SkillSurf/frac-n-pll-vco-mixdes_2026/HFSS Inductor Files/Workflow Development/Inductor_Workflow.drawio (3).png

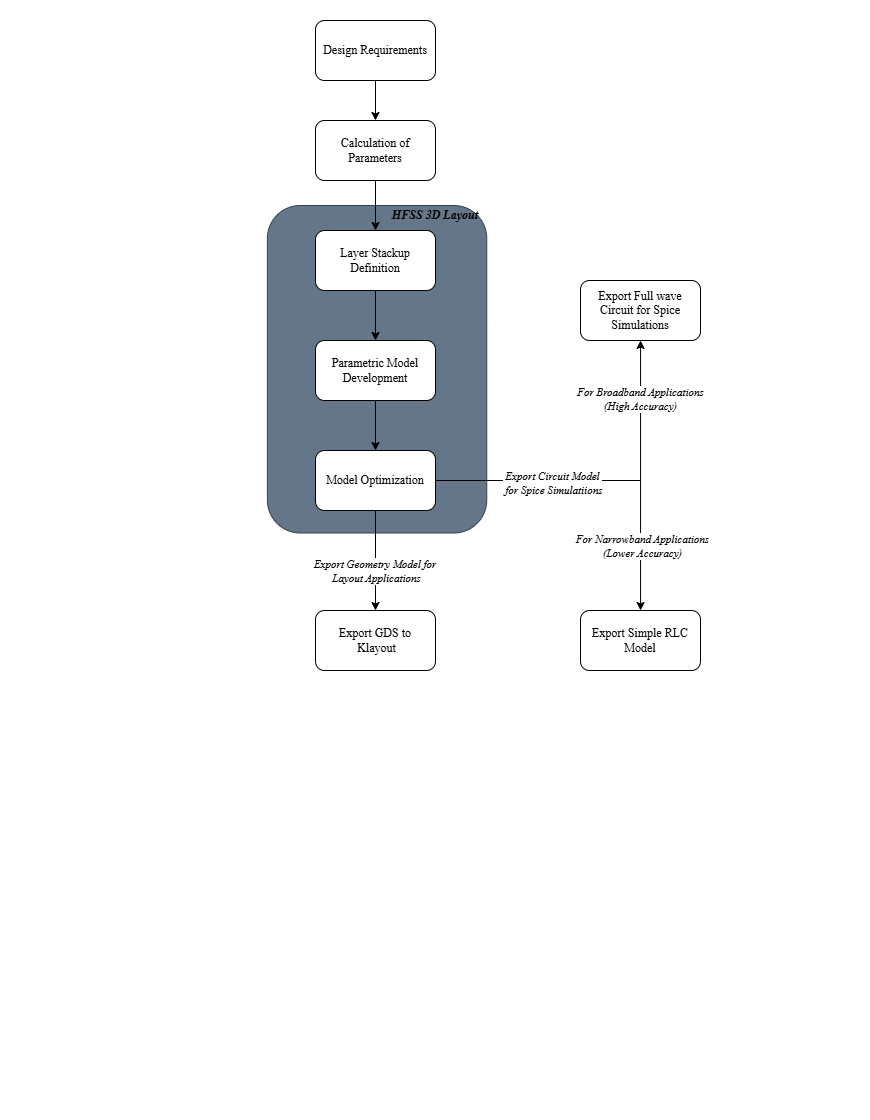
HFSS Inductor Files/Workflow Development/Inductor_Workflow.drawio (3).png
