SkillSurf/frac-n-pll-vco-mixdes_2026/layout/images/PFD.png

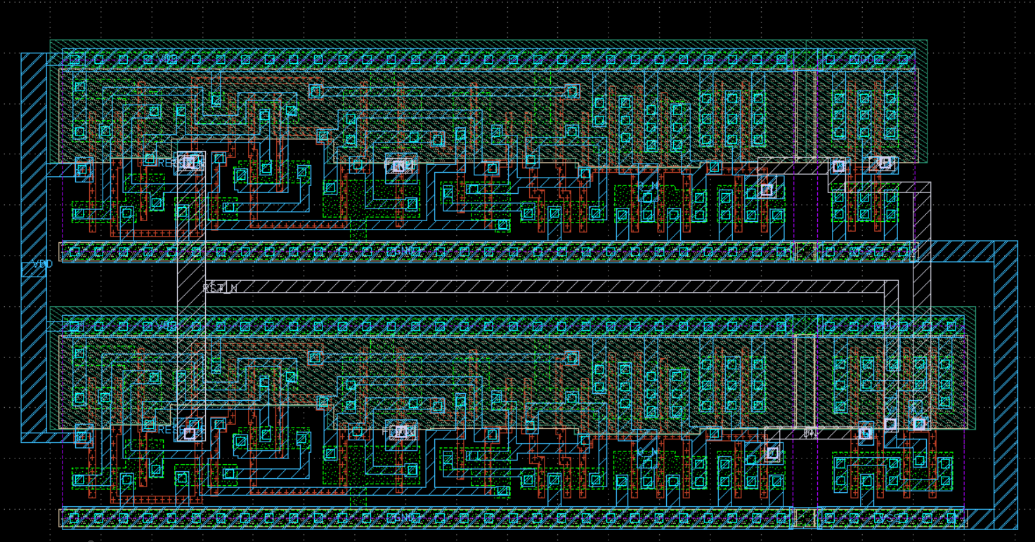
layout/images/PFD.png
