SkillSurf/frac-n-pll-vco-mixdes_2026/pex/images/PFD_CP_pex.png

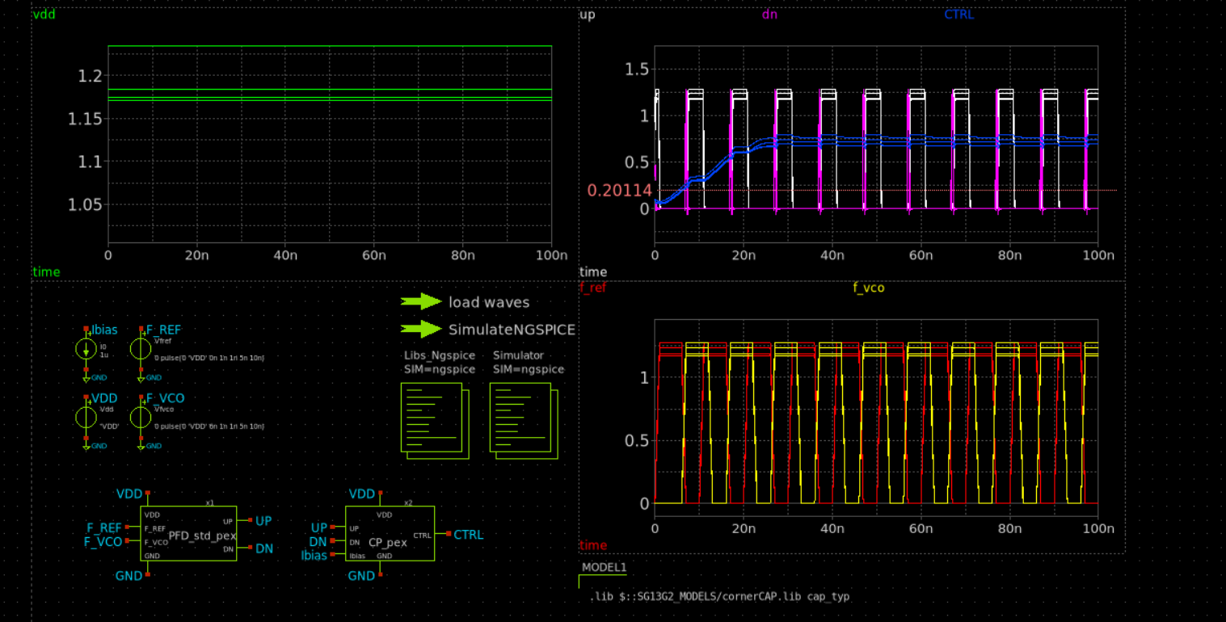
pex/images/PFD_CP_pex.png
