SkillSurf/frac-n-pll-vco-mixdes_2026/schematic/blocks/freq_divider/techmap-stats.png

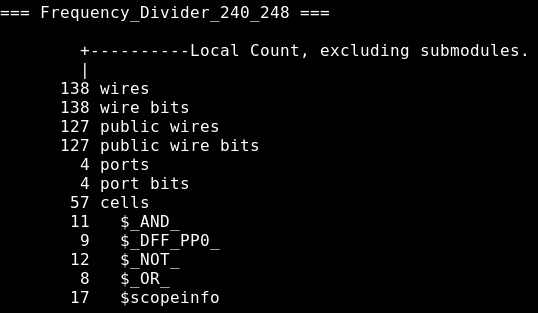
schematic/blocks/freq_divider/techmap-stats.png
