SkillSurf/frac-n-pll-vco-mixdes_2026/schematic/blocks/lc-vco/images/VCO_swing_0.6.png

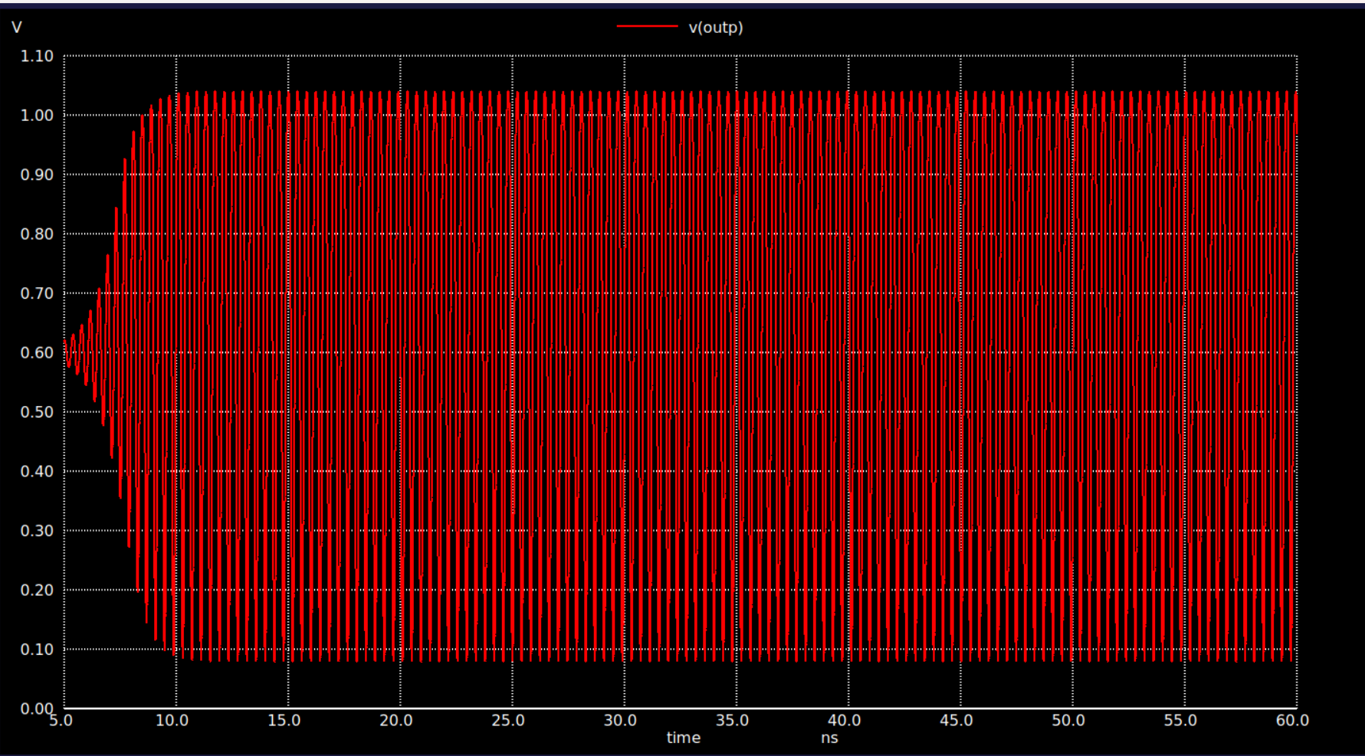
schematic/blocks/lc-vco/images/VCO_swing_0.6.png
