SkillSurf/frac-n-pll-vco-mixdes_2026/schematic/blocks/lc-vco/images/VCO_sym.png

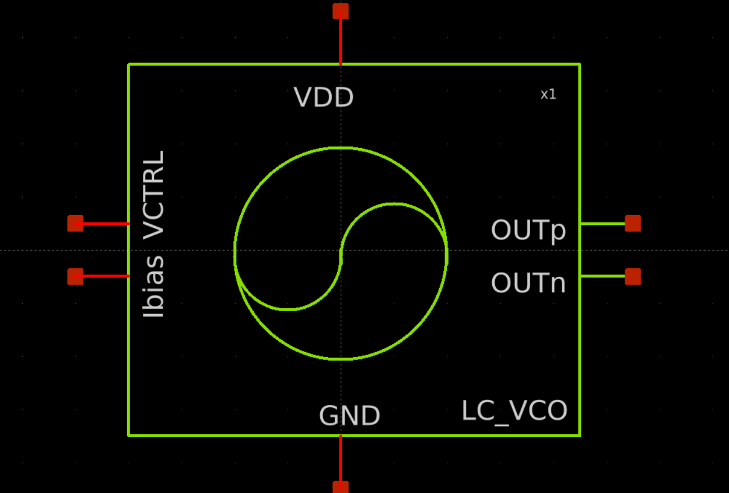
schematic/blocks/lc-vco/images/VCO_sym.png
