SkillSurf/frac-n-pll-vco-mixdes_2026/schematic/blocks/lc-vco/images/VCO_tb.png

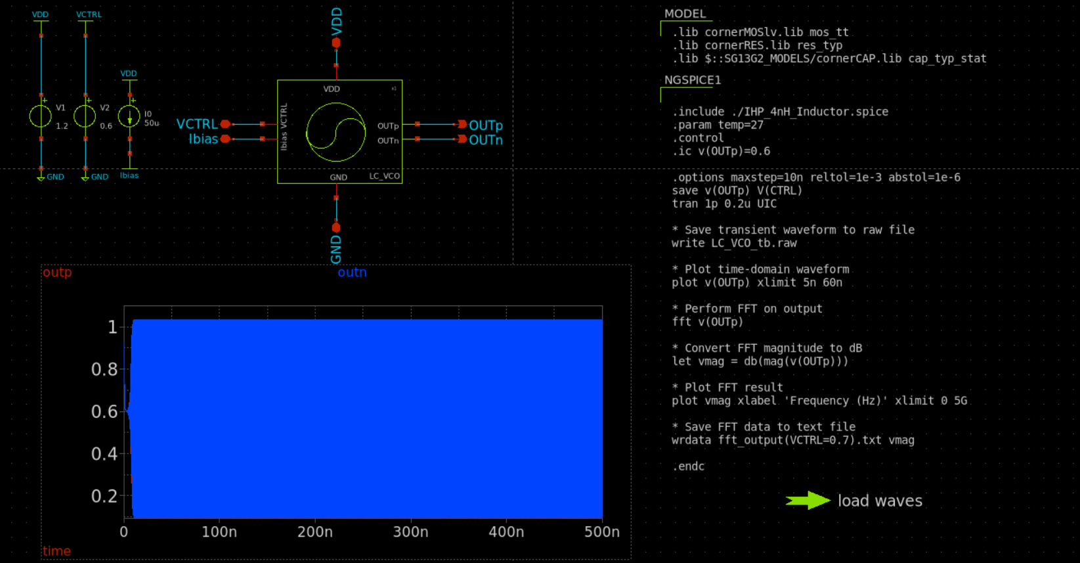
schematic/blocks/lc-vco/images/VCO_tb.png
