SkillSurf/frac-n-pll-vco-mixdes_2026/schematic/blocks/lc-vco/images/VCO_Vcon_vs_Frequency.png

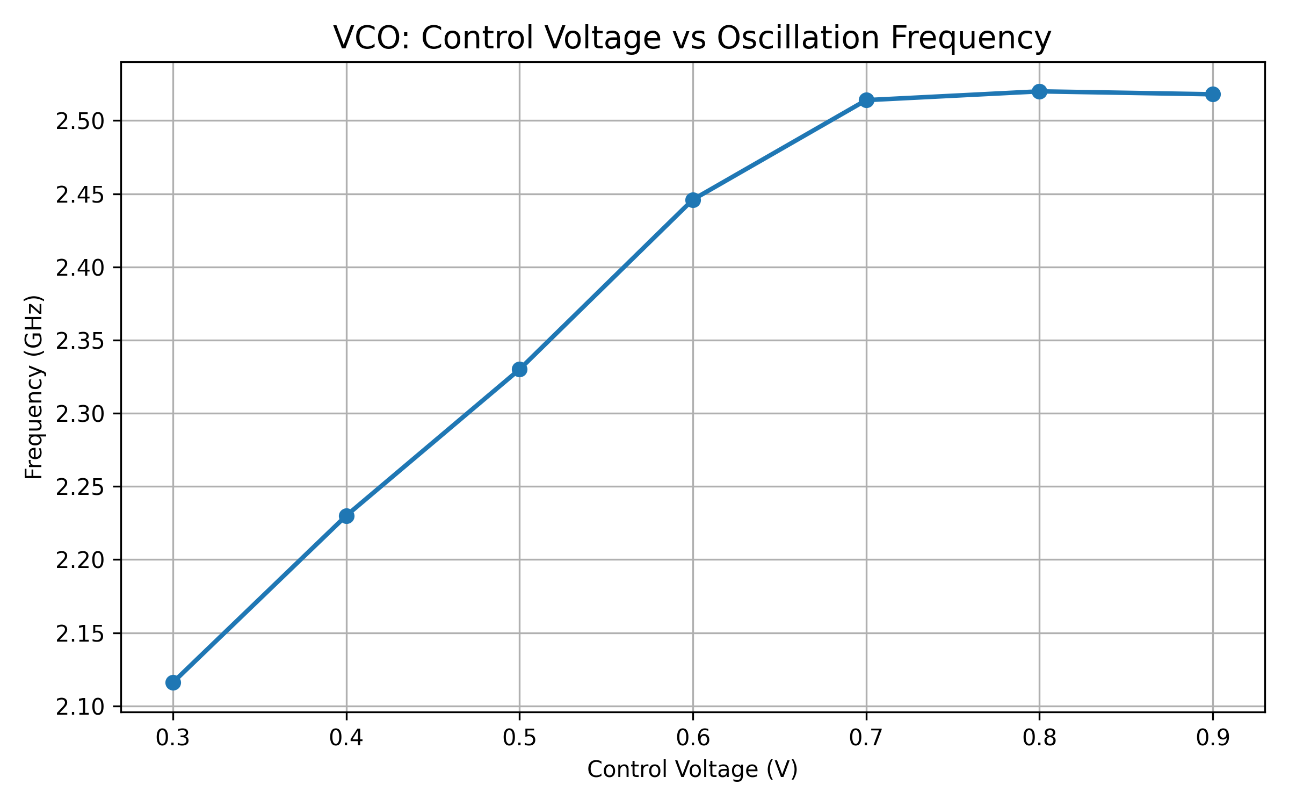
schematic/blocks/lc-vco/images/VCO_Vcon_vs_Frequency.png
