SkillSurf/frac-n-pll-vco-mixdes_2026/schematic/blocks/lc-vco/inductor/images/Inductor_symbol.png

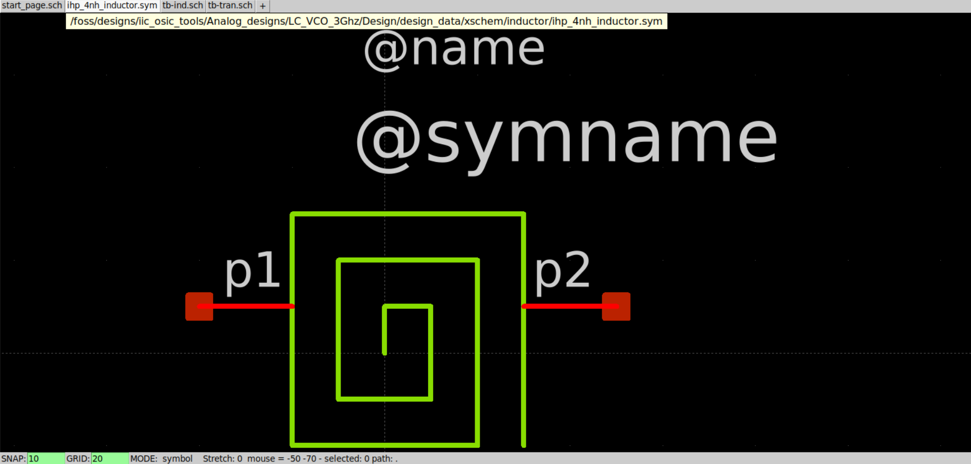
schematic/blocks/lc-vco/inductor/images/Inductor_symbol.png
