SkillSurf/frac-n-pll-vco-mixdes_2026/schematic/blocks/lc-vco/inductor/images/plot_tb_trans.png

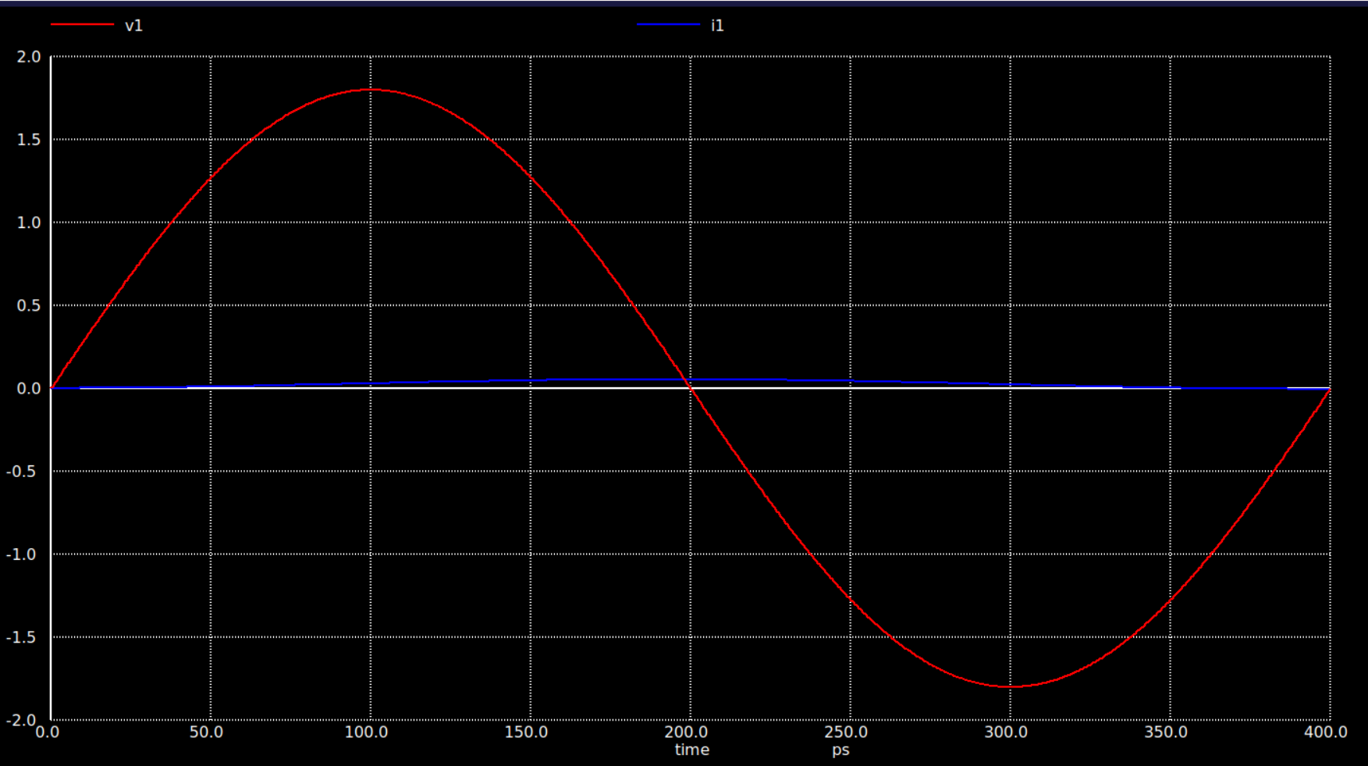
schematic/blocks/lc-vco/inductor/images/plot_tb_trans.png
