SkillSurf/frac-n-pll-vco-mixdes_2026/schematic/blocks/lc-vco/simulations/plot/Phase_Noise_2p45GHz.png

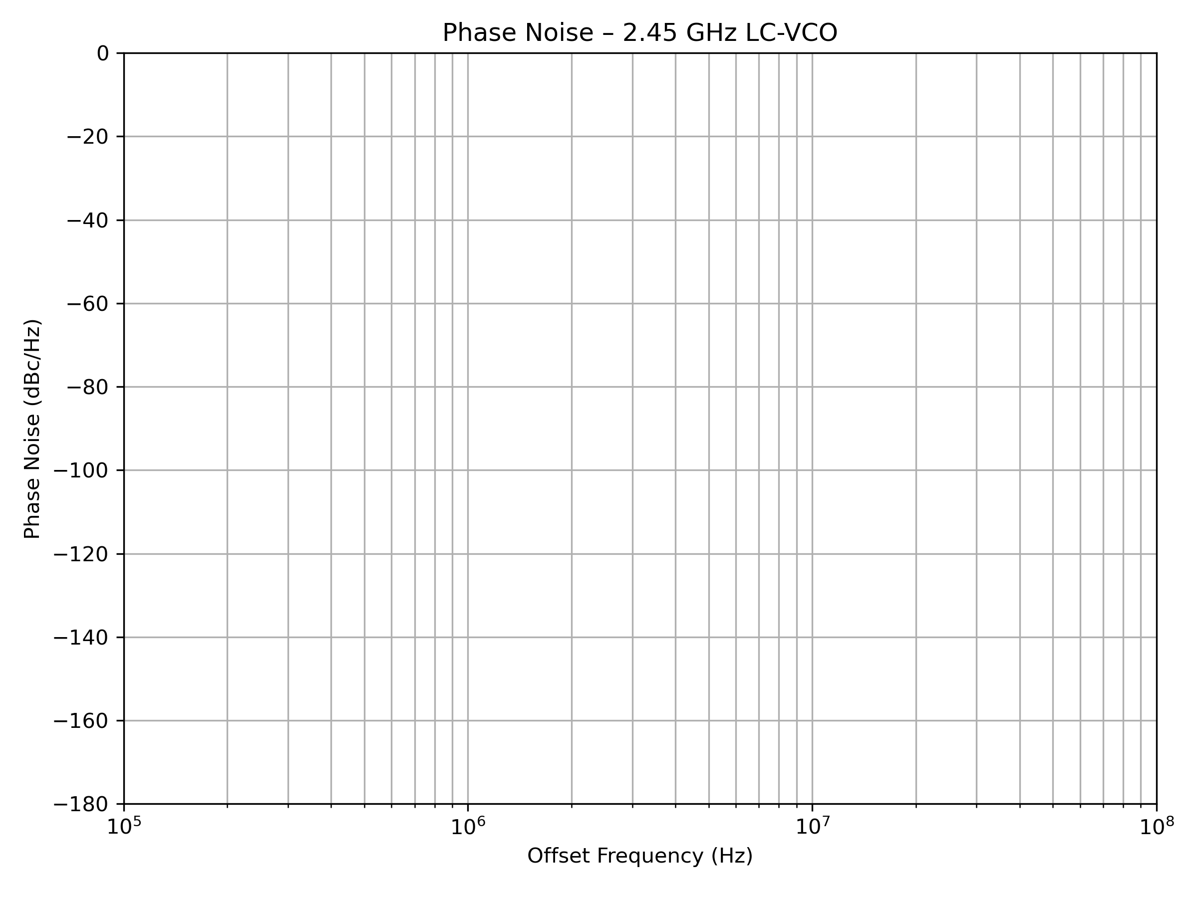
schematic/blocks/lc-vco/simulations/plot/Phase_Noise_2p45GHz.png
