SkillSurf/frac-n-pll-vco-mixdes_2026/schematic/blocks/top-pll/images/Pll_tb.png

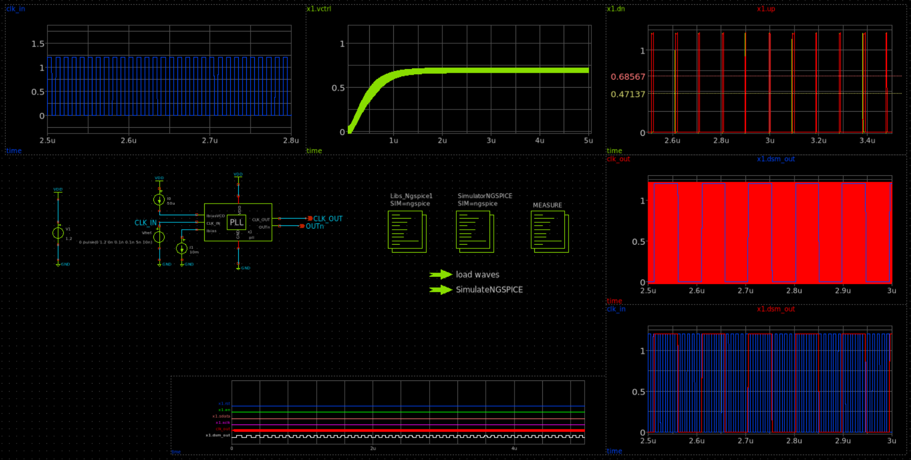
schematic/blocks/top-pll/images/Pll_tb.png
