SkillSurf/frac-n-pll-vco-mixdes_2026/schematic/blocks/top-pll/plots/phase_noise.png

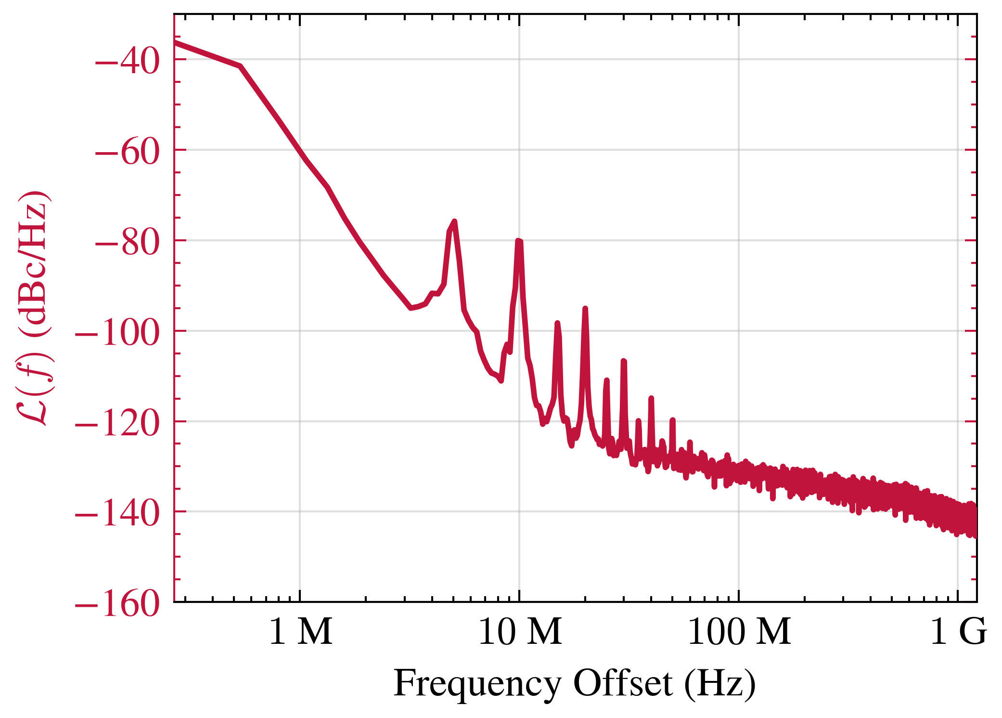
schematic/blocks/top-pll/plots/phase_noise.png
