SkillSurf/frac-n-pll-vco-mixdes_2026/schematic/images/PFD.png

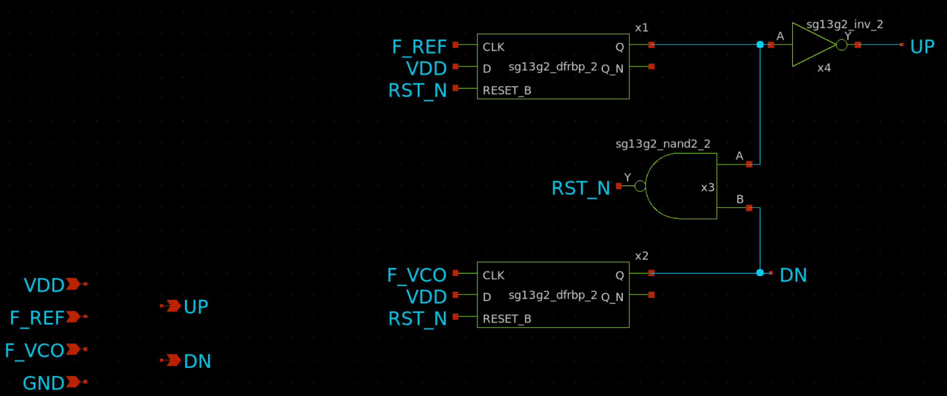
schematic/images/PFD.png
