SkillSurf/frac-n-pll-vco-mixdes_2026/HFSS Inductor Files/Results/Final_Inductor/All_params_5_increased.csv

F [GHz] | Qdiff [] | Ldiff []
0
0.05 | 0.910361637169144 | 4.29419219708574
0.1 | 1.76039034699172 | 4.25789537944545
0.15 | 2.54506056684483 | 4.23875671993914
0.2 | 3.25487046245863 | 4.21809282917082
0.25 | 3.89719435265132 | 4.19805023388162
0.3 | 4.48102549748517 | 4.17944842649672
0.35 | 5.01460024907749 | 4.16243543072328
0.4 | 5.50533651928868 | 4.14693331860913
0.45 | 5.95999063664323 | 4.13282926772102
0.5 | 6.3846467579813 | 4.12003157787052
0.55 | 6.78463216509041 | 4.10847437201323
0.6 | 7.1644562598025 | 4.09810870606439
0.65 | 7.5278060824558 | 4.08889338997171
0.7 | 7.87759221703071 | 4.08078884124879
0.75 | 8.2160265388206 | 4.07375391155874
0.8 | 8.54471414900162 | 4.06774480066577
0.85 | 8.86474696003942 | 4.0627151967697
0.9 | 9.17679157075253 | 4.05861701666249
0.95 | 9.48116795135646 | 4.05540134983289
1 | 9.77791794306177 | 4.05301938340479
1.05 | 10.0690299022583 | 4.05119957784507
1.1 | 10.3542766584777 | 4.05009197370117
1.15 | 10.6337782409399 | 4.04965374898799
1.2 | 10.9076153185074 | 4.04984639711033
1.25 | 11.1758411040774 | 4.0506355244101
1.3 | 11.4384896625119 | 4.05199056652454
1.35 | 11.6955816876259 | 4.0538844688765
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
