SkillSurf/frac-n-pll-vco-mixdes_2026/HFSS Inductor Files/Results/Final_Inductor/Final_inductor.csv

F [GHz] | Qdiff [] | Ldiff []
0
0.05 | 0.862573039718039 | 4.10525818600669
0.1 | 1.67220735884419 | 4.07071218966913
0.15 | 2.42566952697537 | 4.05225157533128
0.2 | 3.11565455376951 | 4.03279449870715
0.25 | 3.74878208598265 | 4.01425768118646
0.3 | 4.33260738004381 | 3.99729994173391
0.35 | 4.87380078047865 | 3.98198138041417
0.4 | 5.37823164227914 | 3.96817067582261
0.45 | 5.85120981924595 | 3.95571534778021
0.5 | 6.29754746685794 | 3.94449109536643
0.55 | 6.72151697179213 | 3.9344052907229
0.6 | 7.12679826210816 | 3.9253881169922
0.65 | 7.51645709816149 | 3.91738327051713
0.7 | 7.89296009178875 | 3.91034131281371
0.75 | 8.25821743618163 | 3.90421572484065
0.8 | 8.61364159552477 | 3.89896094132877
0.85 | 8.96021229511368 | 3.89453163008362
0.9 | 9.29854132849784 | 3.89088266431288
0.95 | 9.62893346703466 | 3.88796942512268
1 | 9.95144173518222 | 3.88574821650602
1.05 | 10.2696115156658 | 3.88389998702406
1.1 | 10.581702154924 | 3.88266829767457
1.15 | 10.8877865917051 | 3.88201003346301
1.2 | 11.1879153720431 | 3.88188712694364
1.25 | 11.4821246913236 | 3.88226610160251
1.3 | 11.7704416163814 | 3.8831175986448
1.35 | 12.0528873993499 | 3.88441591788408
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
