SkillSurf/frac-n-pll-vco-mixdes_2026/HFSS Inductor Files/Results/Final_Inductor/inductor_comparison_plot.png

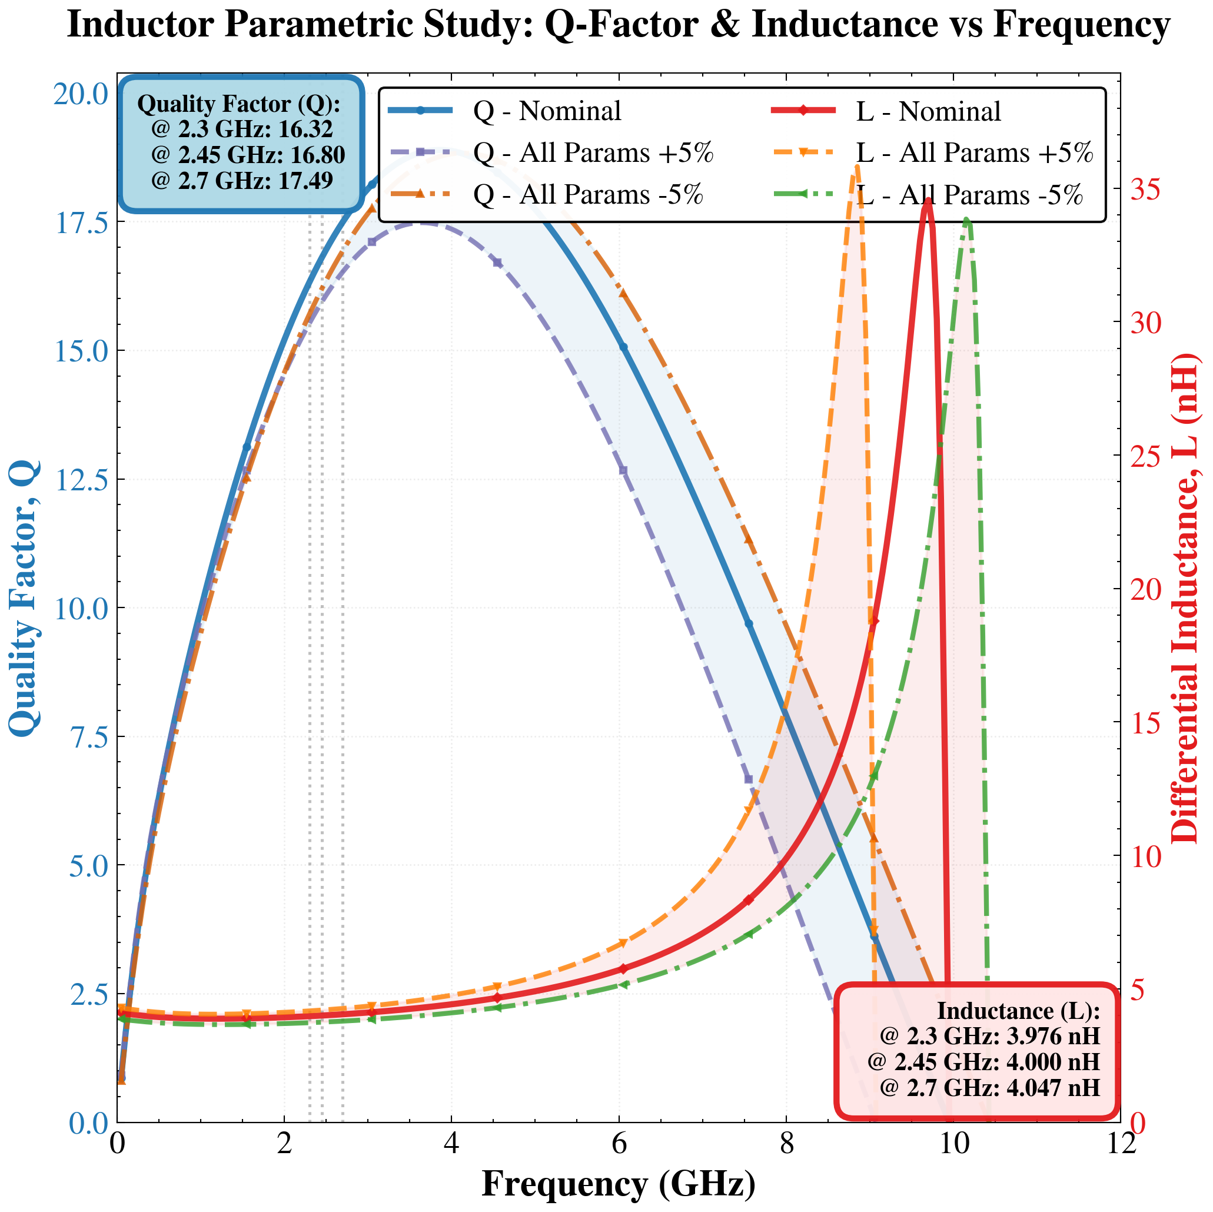
HFSS Inductor Files/Results/Final_Inductor/inductor_comparison_plot.png
