SkillSurf/frac-n-pll-vco-mixdes_2026/HFSS Inductor Files/Results/Results for the 2port inductor/radius_plots/dual_axis_L_Q_vs_frequency.png

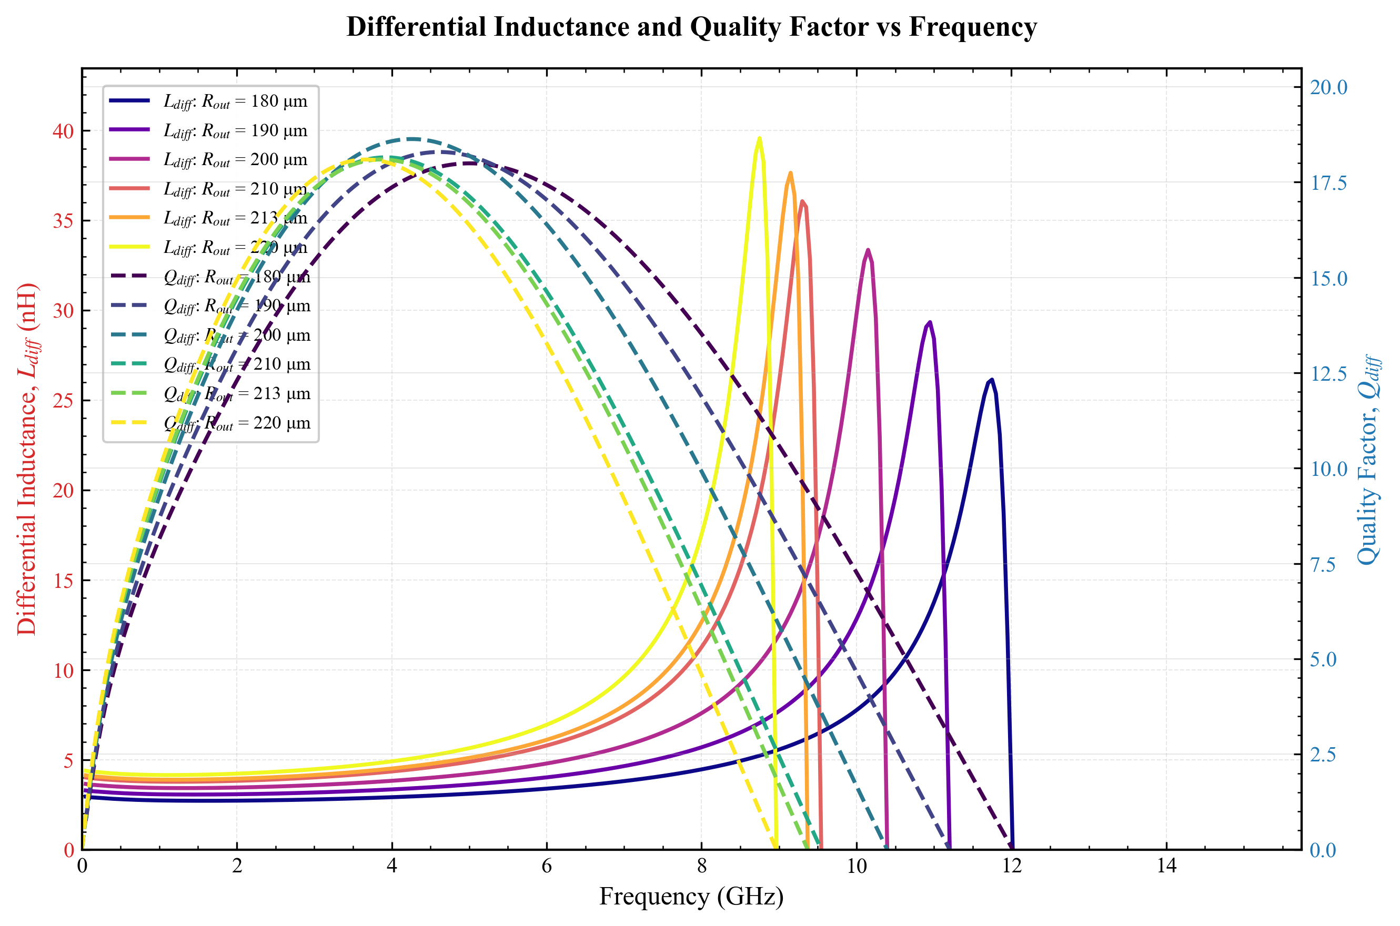
HFSS Inductor Files/Results/Results for the 2port inductor/radius_plots/dual_axis_L_Q_vs_frequency.png
