SkillSurf/frac-n-pll-vco-mixdes_2026/HFSS Inductor Files/Results/Results for the 2port inductor/radius_plots/L_vs_frequency.png

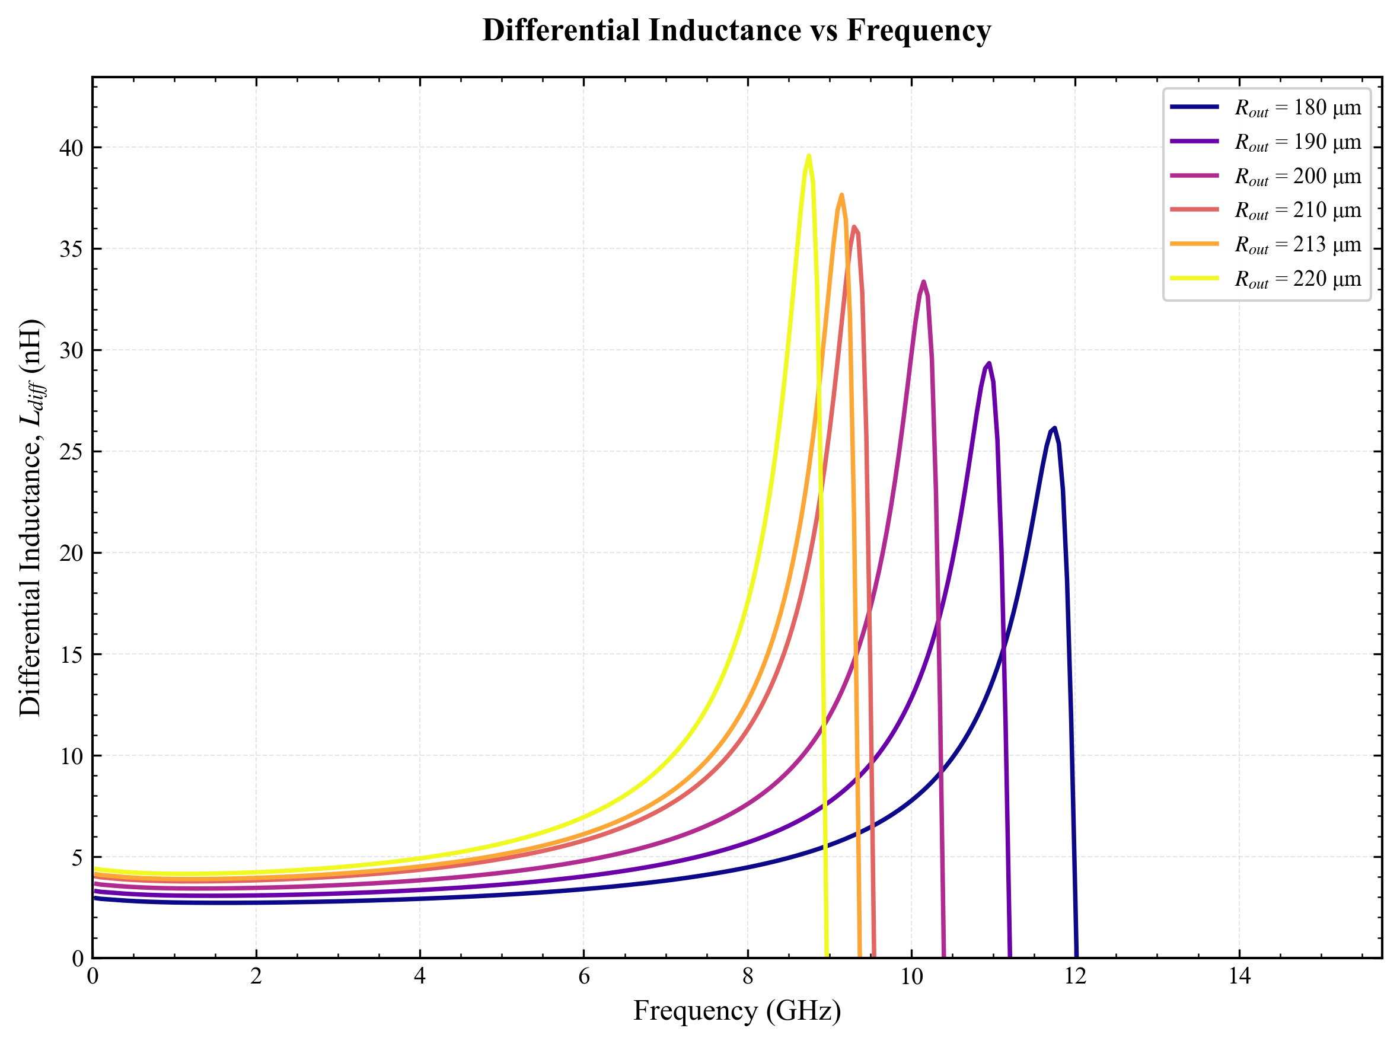
HFSS Inductor Files/Results/Results for the 2port inductor/radius_plots/L_vs_frequency.png
