SkillSurf/frac-n-pll-vco-mixdes_2026/schematic/blocks/top-pll/top_pll_tb.spice

** sch_path: /foss/designs/iic_osic_tools/frac-n-pll-vco-unic_cass/schematic/blocks/top-pll/top_pll_tb.sch
**.subckt top_pll_tb
V1 VDD GND 1.2
.save i(v1)
I0 VDD Vbias2 50u
Vfref CLK_IN GND 0 pulse(0 1.2 0n 1n 1n 50n 100n)
I1 Vbias1 GND 50u
x2 CLK_OUT CLK_IN Vbias2 OUTn Vbias1 VDD GND pll
**** begin user architecture code



*****************************************************
* PLL + DSM Frequency Divider Testbench (Optimized)
*****************************************************

.option temp=27
.param VDD=1.2

* ==============================
* Include Models & Stimuli
* ==============================
.include ./IHP_4nH_Inductor.spice
.include stimuli_test.cir

* ==============================
* Simulation Options (Optimized for Speed & Stability)
* ==============================
* gear method improves stability for long oscillator runs
* reltol=1e-3 prevents the simulator from bogging down on microscopic errors
.options reltol=1e-3 abstol=1e-9 vntol=1e-6 method=gear

* ==============================
* Initial Conditions (Speed Hack)
* ==============================
* Uncomment the line below to pre-charge the loop filter to your expected
* V_tune voltage (e.g., 0.6V). This skips the massive initial frequency jump.
.ic v(x2.vctrl)=0.606
.ic v(x2.x1.ctrl1)=0.606
.ic v(x2.x1.ctrl2)=0.606

.control
  * CRITICAL: Save ONLY essential low-frequency signals.
  * Saving 2.4GHz nodes for 100us will crash your memory.
  save x2.vctrl x2.up x2.dn x2.dsm_out clk_out clk_in vbias1 vbias2
  *save all


  * 20p defines the step to resolve the 2.4 GHz edges without forcing a maxstep.
  tran 30p 100n uic

  remzerovec
  write pll_top.raw
.endc





.lib cornerMOSlv.lib mos_tt
.lib cornerHBT.lib hbt_typ
.lib cornerRES.lib res_typ
.lib cornerCAP.lib cap_typ_stat
.include /foss/pdks/ihp-sg13g2/libs.ref/sg13g2_stdcell/spice/sg13g2_stdcell.spice
.global VDD GND


.param CP_N_L = 0.5u
.param CP_N_W = 10u
.param CP_P_M = 1
.param CP_P_L = 0.5u
.param CP_P_W = 30u
.param CP_N_M = 1
.param C_CP = 1000p


**** end user architecture code
**.ends

* expanding   symbol:  /foss/designs/iic_osic_tools/frac-n-pll-vco-unic_cass/schematic/blocks/top-pll/pll.sym # of pins=7
** sym_path: /foss/designs/iic_osic_tools/frac-n-pll-vco-unic_cass/schematic/blocks/top-pll/pll.sym
** sch_path: /foss/designs/iic_osic_tools/frac-n-pll-vco-unic_cass/schematic/blocks/top-pll/pll.sch
.subckt pll CLK_OUT CLK_IN IbiasVCO OUTn Ibias VDD GND
*.iopin GND
*.iopin VDD
*.ipin CLK_IN
*.ipin IbiasVCO
*.ipin Ibias
*.opin OUTn
*.opin CLK_OUT
x5 CLK_OUT net7 VDD GND sg13g2_inv_2
x1 VDD UP VCTRL DN GND Ibias CP
x2 VDD UP CLK_IN DSM_OUT DN GND PFD_std
adut [ net1 net2 net3 net4 net5 ] [ net6 ] null dut
.model dut d_cosim simulation=./../dsm_and_freq_divider.so
A1 [ CLK_OUT ] [ net1 ] adc1
.model adc1 adc_bridge in_low=0.4 in_high=0.6
A2 [ rst ] [ net2 ] adc1
.model adc1 adc_bridge in_low=0.4 in_high=0.6
A3 [ sclk ] [ net3 ] adc1
.model adc1 adc_bridge in_low=0.4 in_high=0.6
A4 [ sdata ] [ net4 ] adc1
.model adc1 adc_bridge in_low=0.4 in_high=0.6
A5 [ en ] [ net5 ] adc1
.model adc1 adc_bridge in_low=0.4 in_high=0.6
A6 [ net6 ] [ DSM_OUT ] dac1
.model dac1 dac_bridge out_low=0 out_high=1.2
* noconn rst
* noconn sclk
* noconn sdata
* noconn en
x3 VDD net7 OUTn IbiasVCO VCTRL GND LC_VCO
.ends


* expanding   symbol:  /foss/designs/iic_osic_tools/frac-n-pll-vco-unic_cass/schematic/blocks/charge-pump/CP.sym # of pins=6
** sym_path: /foss/designs/iic_osic_tools/frac-n-pll-vco-unic_cass/schematic/blocks/charge-pump/CP.sym
** sch_path: /foss/designs/iic_osic_tools/frac-n-pll-vco-unic_cass/schematic/blocks/charge-pump/CP.sch
.subckt CP VDD UP CTRL DN GND Ibias
*.opin CTRL
*.ipin UP
*.ipin VDD
*.ipin Ibias
*.ipin DN
*.ipin GND
XM2 Vbn Vbn net2 GND sg13_lv_nmos w={CP_N_W} l={CP_N_L} ng=1 m={CP_N_M}
XM1 net2 VDD GND GND sg13_lv_nmos w={CP_N_W} l={CP_N_L} ng=1 m={CP_N_M}
XM3 Vbn Vbp net1 VDD sg13_lv_pmos w={CP_P_W} l={CP_P_L} ng=1 m={CP_P_M}
XM4 net1 GND VDD VDD sg13_lv_pmos w={CP_P_W} l={CP_P_L} ng=1 m={CP_P_M}
XM7 Vbp Vbp net5 VDD sg13_lv_pmos w={CP_P_W} l={CP_P_L} ng=1 m={CP_P_M}
XM8 net5 GND VDD VDD sg13_lv_pmos w={CP_P_W} l={CP_P_L} ng=1 m={CP_P_M}
XM5 CTRL1 Vbn net3 GND sg13_lv_nmos w={CP_N_W} l={CP_N_L} ng=1 m={CP_N_M}
XM6 net3 DN GND GND sg13_lv_nmos w={CP_N_W} l={CP_N_L} ng=1 m={CP_N_M}
XM9 CTRL1 Vbp net4 VDD sg13_lv_pmos w={CP_P_W} l={CP_P_L} ng=1 m={CP_P_M}
XM10 net4 UP VDD VDD sg13_lv_pmos w={CP_P_W} l={CP_P_L} ng=1 m={CP_P_M}
XC1 CTRL GND cparasitic C='C_CP'
XR3 CTRL1 CTRL sub! rsil w=0.5e-6 l=1e-5 m=1 b=0
XC2 CTRL2 GND cparasitic C='C_CP'
XR2 CTRL1 CTRL2 sub! rsil w=0.5e-6 l=1e-5 m=1 b=0
XC3 CTRL1 GND cparasitic C='C_CP'
R1 Vbp Ibias 0 m=1
.ends


* expanding   symbol:  /foss/designs/iic_osic_tools/frac-n-pll-vco-unic_cass/schematic/blocks/phase-freq-detector/PFD_std.sym # of
*+ pins=6
** sym_path: /foss/designs/iic_osic_tools/frac-n-pll-vco-unic_cass/schematic/blocks/phase-freq-detector/PFD_std.sym
** sch_path: /foss/designs/iic_osic_tools/frac-n-pll-vco-unic_cass/schematic/blocks/phase-freq-detector/PFD_std.sch
.subckt PFD_std VDD UP F_REF F_VCO DN GND
*.opin UP
*.ipin F_REF
*.ipin VDD
*.ipin GND
*.opin DN
*.ipin F_VCO
x1 net1 net2 F_REF VDD RST_N VDD GND sg13g2_dfrbp_2
x2 DN net3 F_VCO VDD RST_N VDD GND sg13g2_dfrbp_2
x3 RST_N net1 DN VDD GND sg13g2_nand2_2
x4 UP net1 VDD GND sg13g2_inv_2
.ends


* expanding   symbol:  /foss/designs/iic_osic_tools/frac-n-pll-vco-unic_cass/schematic/blocks/lc-vco/LC_VCO.sym # of pins=6
** sym_path: /foss/designs/iic_osic_tools/frac-n-pll-vco-unic_cass/schematic/blocks/lc-vco/LC_VCO.sym
** sch_path: /foss/designs/iic_osic_tools/frac-n-pll-vco-unic_cass/schematic/blocks/lc-vco/LC_VCO.sch
.subckt LC_VCO VDD OUTp OUTn Ibias VCTRL GND
*.iopin VDD
*.opin OUTp
*.opin OUTn
*.iopin GND
*.iopin VCTRL
*.iopin Ibias
XM6 net1 Ibias GND GND sg13_lv_nmos w=1u l=0.15u ng=1 m=60
XM5 Ibias Ibias GND GND sg13_lv_nmos w=1u l=0.15u ng=1 m=1
XM4 OUTp OUTn VDD VDD sg13_lv_pmos w=8.5u l=0.5u ng=1 m=13
X5M3 OUTn OUTp VDD VDD sg13_lv_pmos w=8.5u l=0.5u ng=1 m=13
XM2 OUTp OUTn net1 GND sg13_lv_nmos w=2u l=0.5u ng=1 m=12
XM1 OUTn OUTp net1 GND sg13_lv_nmos w=2u l=0.5u ng=1 m=12
XC3 OUTp OUTn cap_cmim w=4.0e-6 l=4.0e-6 m=13.6
XMv2 OUTp VCTRL OUTp VDD sg13_lv_pmos w=4u l=4u ng=1 m=22
XMv1 OUTn VCTRL OUTn VDD sg13_lv_pmos w=4u l=4u ng=1 m=22
XR1 OUTn OUTp sub! rhigh w=1e-6 l=1e-6 m=1.23 b=0
x1 OUTn OUTp ihp_4nh_inductor
.ends

.GLOBAL GND
.GLOBAL VDD
.end
