SkillSurf/frac-n-pll-vco-mixdes_2026/schematic/blocks/phase-freq-detector/simulations/PFD_lvs.spice

** sch_path: /foss/designs/iic_osic_tools/frac-n-pll-vco-unic_cass/schematic/blocks/phase-freq-detector/PFD_std.sch
.include "/foss/pdks/ihp-sg13g2/libs.ref/sg13g2_stdcell/cdl/sg13g2_stdcell.cdl"
.SUBCKT PFD VDD UP F_REF F_VCO DN GND

x1 net1 net2 F_REF VDD RST_N VDD GND SG13G2_DFRBP_2
x2 DN   net3 F_VCO VDD RST_N VDD GND SG13G2_DFRBP_2
x3 RST_N net1 DN VDD GND SG13G2_NAND2_2
x4 UP    net1 VDD GND SG13G2_INV_2

.ENDS
