SkillSurf/frac-n-pll-vco-mixdes_2026/schematic/blocks/lc-vco/simulations/LC_VCO.pex.spice

* NGSPICE file created from LC_VCO.ext - technology: ihp-sg13g2

.subckt LC_VCO IBIAS OUTp OUTn VCTRL GND VDD
X0 OUTn OUTp a_n11430_n13770# GND sg13_lv_nmos ad=0.38p pd=2.38u as=0.68p ps=4.68u w=2u l=0.5u
X1 OUTp OUTn cap_cmim l=4.26u w=4.26u
X2 OUTp OUTn sub! rhigh l=0.79u w=1u
X3 a_n11430_n13770# IBIAS GND GND sg13_lv_nmos ad=0.19p pd=1.38u as=0.19p ps=1.38u w=1u l=0.15u
X4 OUTn VCTRL OUTn VDD sg13_lv_pmos ad=0.76p pd=4.38u as=87.38535p ps=0.73027m w=4u l=4u
X5 VDD OUTn OUTp VDD sg13_lv_pmos ad=1.615p pd=8.88u as=1.615p ps=8.88u w=8.5u l=0.5u
X6 GND IBIAS a_n11430_n13770# GND sg13_lv_nmos ad=0.19p pd=1.38u as=0.19p ps=1.38u w=1u l=0.15u
X7 OUTn VCTRL OUTn VDD sg13_lv_pmos ad=0.76p pd=4.38u as=0 ps=0 w=4u l=4u
X8 OUTn OUTp a_n11430_n13770# GND sg13_lv_nmos ad=0.38p pd=2.38u as=0.38p ps=2.38u w=2u l=0.5u
X9 a_n11430_n13770# IBIAS GND GND sg13_lv_nmos ad=0.19p pd=1.38u as=0.19p ps=1.38u w=1u l=0.15u
X10 a_n11430_n13770# IBIAS GND GND sg13_lv_nmos ad=0.19p pd=1.38u as=0.19p ps=1.38u w=1u l=0.15u
X11 OUTp OUTn a_n11430_n13770# GND sg13_lv_nmos ad=0.38p pd=2.38u as=0.38p ps=2.38u w=2u l=0.5u
X12 GND IBIAS a_n11430_n13770# GND sg13_lv_nmos ad=0.19p pd=1.38u as=0.19p ps=1.38u w=1u l=0.15u
X13 OUTp VCTRL OUTp VDD sg13_lv_pmos ad=0.76p pd=4.38u as=87.38047p ps=0.73022m w=4u l=4u
X14 OUTp VCTRL OUTp VDD sg13_lv_pmos ad=0.76p pd=4.38u as=0 ps=0 w=4u l=4u
X15 GND IBIAS a_n11430_n13770# GND sg13_lv_nmos ad=0.19p pd=1.38u as=0.19p ps=1.38u w=1u l=0.15u
X16 OUTp OUTn VDD VDD sg13_lv_pmos ad=2.89p pd=17.68u as=1.615p ps=8.88u w=8.5u l=0.5u
X17 a_n11430_n13770# IBIAS GND GND sg13_lv_nmos ad=0.19p pd=1.38u as=0.19p ps=1.38u w=1u l=0.15u
X18 OUTp OUTn cap_cmim l=4.26u w=4.26u
X19 OUTn VCTRL OUTn VDD sg13_lv_pmos ad=0.76p pd=4.38u as=0 ps=0 w=4u l=4u
X20 a_n11430_n13770# IBIAS GND GND sg13_lv_nmos ad=0.19p pd=1.38u as=0.19p ps=1.38u w=1u l=0.15u
X21 OUTp OUTn cap_cmim l=4.26u w=4.26u
X22 OUTp OUTn a_n11430_n13770# GND sg13_lv_nmos ad=0.38p pd=2.38u as=0.68p ps=4.68u w=2u l=0.5u
X23 a_n11430_n13770# IBIAS GND GND sg13_lv_nmos ad=0.19p pd=1.38u as=0.19p ps=1.38u w=1u l=0.15u
X24 OUTn VCTRL OUTn VDD sg13_lv_pmos ad=0.76p pd=4.38u as=0 ps=0 w=4u l=4u
X25 OUTn OUTp VDD VDD sg13_lv_pmos ad=1.615p pd=8.88u as=1.615p ps=8.88u w=8.5u l=0.5u
X26 OUTn OUTp VDD VDD sg13_lv_pmos ad=1.615p pd=8.88u as=1.615p ps=8.88u w=8.5u l=0.5u
X27 OUTn VCTRL OUTn VDD sg13_lv_pmos ad=0.76p pd=4.38u as=0 ps=0 w=4u l=4u
X28 GND IBIAS a_n11430_n13770# GND sg13_lv_nmos ad=0.19p pd=1.38u as=0.19p ps=1.38u w=1u l=0.15u
X29 OUTp OUTn a_n11430_n13770# GND sg13_lv_nmos ad=0.38p pd=2.38u as=0.38p ps=2.38u w=2u l=0.5u
X30 OUTp OUTn a_n11430_n13770# GND sg13_lv_nmos ad=0.38p pd=2.38u as=0.38p ps=2.38u w=2u l=0.5u
X31 OUTn VCTRL OUTn VDD sg13_lv_pmos ad=0.76p pd=4.38u as=0 ps=0 w=4u l=4u
X32 a_n11430_n13770# IBIAS GND GND sg13_lv_nmos ad=0.19p pd=1.38u as=0.19p ps=1.38u w=1u l=0.15u
X33 a_n11430_n13770# IBIAS GND GND sg13_lv_nmos ad=0.19p pd=1.38u as=0.34p ps=2.68u w=1u l=0.15u
X34 OUTn OUTp VDD VDD sg13_lv_pmos ad=1.615p pd=8.88u as=1.615p ps=8.88u w=8.5u l=0.5u
X35 OUTn VCTRL OUTn VDD sg13_lv_pmos ad=1.36p pd=8.68u as=0 ps=0 w=4u l=4u
X36 VDD OUTn OUTp VDD sg13_lv_pmos ad=1.615p pd=8.88u as=1.615p ps=8.88u w=8.5u l=0.5u
X37 VDD OUTn OUTp VDD sg13_lv_pmos ad=1.615p pd=8.88u as=1.615p ps=8.88u w=8.5u l=0.5u
X38 GND IBIAS a_n11430_n13770# GND sg13_lv_nmos ad=0.19p pd=1.38u as=0.19p ps=1.38u w=1u l=0.15u
X39 OUTp OUTn a_n11430_n13770# GND sg13_lv_nmos ad=0.38p pd=2.38u as=0.38p ps=2.38u w=2u l=0.5u
X40 OUTp OUTn cap_cmim l=4.26u w=4.26u
X41 OUTp OUTn cap_cmim l=4.26u w=4.26u
X42 a_n11430_n13770# IBIAS GND GND sg13_lv_nmos ad=0.19p pd=1.38u as=0.19p ps=1.38u w=1u l=0.15u
X43 GND IBIAS a_n11430_n13770# GND sg13_lv_nmos ad=0.19p pd=1.38u as=0.19p ps=1.38u w=1u l=0.15u
X44 OUTn VCTRL OUTn VDD sg13_lv_pmos ad=0.76p pd=4.38u as=0 ps=0 w=4u l=4u
X45 OUTn OUTp VDD VDD sg13_lv_pmos ad=1.615p pd=8.88u as=1.615p ps=8.88u w=8.5u l=0.5u
X46 a_n11430_n13770# OUTp OUTn GND sg13_lv_nmos ad=0.38p pd=2.38u as=0.38p ps=2.38u w=2u l=0.5u
X47 a_n11430_n13770# IBIAS GND GND sg13_lv_nmos ad=0.19p pd=1.38u as=0.19p ps=1.38u w=1u l=0.15u
X48 GND IBIAS a_n11430_n13770# GND sg13_lv_nmos ad=0.19p pd=1.38u as=0.19p ps=1.38u w=1u l=0.15u
X49 OUTn OUTp VDD VDD sg13_lv_pmos ad=1.615p pd=8.88u as=1.615p ps=8.88u w=8.5u l=0.5u
X50 GND IBIAS a_n11430_n13770# GND sg13_lv_nmos ad=0.19p pd=1.38u as=0.19p ps=1.38u w=1u l=0.15u
X51 a_n11430_n13770# IBIAS GND GND sg13_lv_nmos ad=0.19p pd=1.38u as=0.19p ps=1.38u w=1u l=0.15u
X52 a_n11430_n13770# IBIAS GND GND sg13_lv_nmos ad=0.19p pd=1.38u as=0.19p ps=1.38u w=1u l=0.15u
X53 GND IBIAS a_n11430_n13770# GND sg13_lv_nmos ad=0.19p pd=1.38u as=0.19p ps=1.38u w=1u l=0.15u
X54 OUTp VCTRL OUTp VDD sg13_lv_pmos ad=0.76p pd=4.38u as=0 ps=0 w=4u l=4u
X55 GND IBIAS a_n11430_n13770# GND sg13_lv_nmos ad=0.19p pd=1.38u as=0.19p ps=1.38u w=1u l=0.15u
X56 OUTp VCTRL OUTp VDD sg13_lv_pmos ad=0.76p pd=4.38u as=0 ps=0 w=4u l=4u
X57 OUTn OUTp a_n11430_n13770# GND sg13_lv_nmos ad=0.38p pd=2.38u as=0.38p ps=2.38u w=2u l=0.5u
X58 OUTn VCTRL OUTn VDD sg13_lv_pmos ad=0.76p pd=4.38u as=0 ps=0 w=4u l=4u
X59 OUTn OUTp a_n11430_n13770# GND sg13_lv_nmos ad=0.38p pd=2.38u as=0.38p ps=2.38u w=2u l=0.5u
X60 OUTp OUTn a_n11430_n13770# GND sg13_lv_nmos ad=0.38p pd=2.38u as=0.38p ps=2.38u w=2u l=0.5u
X61 OUTp OUTn cap_cmim l=4.26u w=4.26u
X62 OUTp VCTRL OUTp VDD sg13_lv_pmos ad=0.76p pd=4.38u as=0 ps=0 w=4u l=4u
X63 OUTp VCTRL OUTp VDD sg13_lv_pmos ad=0.76p pd=4.38u as=0 ps=0 w=4u l=4u
X64 a_n11430_n13770# OUTp OUTn GND sg13_lv_nmos ad=0.38p pd=2.38u as=0.38p ps=2.38u w=2u l=0.5u
X65 a_n11430_n13770# IBIAS GND GND sg13_lv_nmos ad=0.19p pd=1.38u as=0.19p ps=1.38u w=1u l=0.15u
X66 VDD OUTn OUTp VDD sg13_lv_pmos ad=1.615p pd=8.88u as=1.615p ps=8.88u w=8.5u l=0.5u
X67 OUTp VCTRL OUTp VDD sg13_lv_pmos ad=0.76p pd=4.38u as=0 ps=0 w=4u l=4u
X68 GND IBIAS a_n11430_n13770# GND sg13_lv_nmos ad=0.19p pd=1.38u as=0.19p ps=1.38u w=1u l=0.15u
X69 a_n11430_n13770# IBIAS GND GND sg13_lv_nmos ad=0.19p pd=1.38u as=0.19p ps=1.38u w=1u l=0.15u
X70 GND IBIAS a_n11430_n13770# GND sg13_lv_nmos ad=0.19p pd=1.38u as=0.19p ps=1.38u w=1u l=0.15u
X71 a_n11430_n13770# IBIAS GND GND sg13_lv_nmos ad=0.19p pd=1.38u as=0.19p ps=1.38u w=1u l=0.15u
X72 OUTn VCTRL OUTn VDD sg13_lv_pmos ad=0.76p pd=4.38u as=0 ps=0 w=4u l=4u
X73 OUTn OUTp VDD VDD sg13_lv_pmos ad=1.615p pd=8.88u as=1.615p ps=8.88u w=8.5u l=0.5u
X74 GND IBIAS a_n11430_n13770# GND sg13_lv_nmos ad=0.19p pd=1.38u as=0.19p ps=1.38u w=1u l=0.15u
X75 a_n11430_n13770# IBIAS GND GND sg13_lv_nmos ad=0.19p pd=1.38u as=0.19p ps=1.38u w=1u l=0.15u
X76 OUTn VCTRL OUTn VDD sg13_lv_pmos ad=0.76p pd=4.38u as=0 ps=0 w=4u l=4u
X77 GND IBIAS a_n11430_n13770# GND sg13_lv_nmos ad=0.19p pd=1.38u as=0.19p ps=1.38u w=1u l=0.15u
X78 OUTp OUTn cap_cmim l=4.26u w=4.26u
X79 OUTn OUTp a_n11430_n13770# GND sg13_lv_nmos ad=0.38p pd=2.38u as=0.38p ps=2.38u w=2u l=0.5u
X80 OUTp VCTRL OUTp VDD sg13_lv_pmos ad=0.76p pd=4.38u as=0 ps=0 w=4u l=4u
X81 VDD OUTn OUTp VDD sg13_lv_pmos ad=1.615p pd=8.88u as=1.615p ps=8.88u w=8.5u l=0.5u
X82 OUTn VCTRL OUTn VDD sg13_lv_pmos ad=1.36p pd=8.68u as=0 ps=0 w=4u l=4u
X83 VDD OUTn OUTp VDD sg13_lv_pmos ad=1.615p pd=8.88u as=1.615p ps=8.88u w=8.5u l=0.5u
X84 OUTp VCTRL OUTp VDD sg13_lv_pmos ad=0.76p pd=4.38u as=0 ps=0 w=4u l=4u
X85 GND IBIAS a_n11430_n13770# GND sg13_lv_nmos ad=0.19p pd=1.38u as=0.19p ps=1.38u w=1u l=0.15u
X86 OUTp VCTRL OUTp VDD sg13_lv_pmos ad=1.36p pd=8.68u as=0 ps=0 w=4u l=4u
X87 GND IBIAS a_n11430_n13770# GND sg13_lv_nmos ad=0.19p pd=1.38u as=0.19p ps=1.38u w=1u l=0.15u
X88 GND IBIAS a_n11430_n13770# GND sg13_lv_nmos ad=0.19p pd=1.38u as=0.19p ps=1.38u w=1u l=0.15u
X89 OUTn VCTRL OUTn VDD sg13_lv_pmos ad=0.76p pd=4.38u as=0 ps=0 w=4u l=4u
X90 a_n11430_n13770# IBIAS GND GND sg13_lv_nmos ad=0.19p pd=1.38u as=0.19p ps=1.38u w=1u l=0.15u
X91 a_n11430_n13770# IBIAS GND GND sg13_lv_nmos ad=0.19p pd=1.38u as=0.19p ps=1.38u w=1u l=0.15u
X92 a_n11430_n13770# OUTp OUTn GND sg13_lv_nmos ad=0.38p pd=2.38u as=0.38p ps=2.38u w=2u l=0.5u
X93 GND IBIAS a_n11430_n13770# GND sg13_lv_nmos ad=0.19p pd=1.38u as=0.19p ps=1.38u w=1u l=0.15u
X94 a_n11430_n13770# IBIAS GND GND sg13_lv_nmos ad=0.19p pd=1.38u as=0.19p ps=1.38u w=1u l=0.15u
X95 OUTp OUTn cap_cmim l=4.26u w=4.26u
X96 GND IBIAS a_n11430_n13770# GND sg13_lv_nmos ad=0.19p pd=1.38u as=0.19p ps=1.38u w=1u l=0.15u
X97 OUTp OUTn cap_cmim l=4.26u w=4.26u
X98 OUTp OUTn VDD VDD sg13_lv_pmos ad=1.615p pd=8.88u as=1.615p ps=8.88u w=8.5u l=0.5u
X99 OUTp VCTRL OUTp VDD sg13_lv_pmos ad=0.76p pd=4.38u as=0 ps=0 w=4u l=4u
X100 OUTp VCTRL OUTp VDD sg13_lv_pmos ad=0.76p pd=4.38u as=0 ps=0 w=4u l=4u
X101 a_n11430_n13770# OUTn OUTp GND sg13_lv_nmos ad=0.68p pd=4.68u as=0.38p ps=2.38u w=2u l=0.5u
X102 VDD OUTp OUTn VDD sg13_lv_pmos ad=1.615p pd=8.88u as=1.615p ps=8.88u w=8.5u l=0.5u
X103 OUTp OUTn cap_cmim l=4.26u w=4.26u
X104 OUTp OUTn VDD VDD sg13_lv_pmos ad=1.615p pd=8.88u as=1.615p ps=8.88u w=8.5u l=0.5u
X105 OUTn VCTRL OUTn VDD sg13_lv_pmos ad=0.76p pd=4.38u as=0 ps=0 w=4u l=4u
X106 OUTp VCTRL OUTp VDD sg13_lv_pmos ad=0.76p pd=4.38u as=0 ps=0 w=4u l=4u
X107 OUTp VCTRL OUTp VDD sg13_lv_pmos ad=0.76p pd=4.38u as=0 ps=0 w=4u l=4u
X108 VDD OUTp OUTn VDD sg13_lv_pmos ad=1.615p pd=8.88u as=1.615p ps=8.88u w=8.5u l=0.5u
X109 GND IBIAS a_n11430_n13770# GND sg13_lv_nmos ad=0.19p pd=1.38u as=0.19p ps=1.38u w=1u l=0.15u
X110 GND IBIAS a_n11430_n13770# GND sg13_lv_nmos ad=0.19p pd=1.38u as=0.19p ps=1.38u w=1u l=0.15u
X111 OUTn OUTp a_n11430_n13770# GND sg13_lv_nmos ad=0.38p pd=2.38u as=0.38p ps=2.38u w=2u l=0.5u
X112 OUTn VCTRL OUTn VDD sg13_lv_pmos ad=0.76p pd=4.38u as=0 ps=0 w=4u l=4u
X113 OUTn VCTRL OUTn VDD sg13_lv_pmos ad=0.76p pd=4.38u as=0 ps=0 w=4u l=4u
X114 a_n11430_n13770# OUTn OUTp GND sg13_lv_nmos ad=0.38p pd=2.38u as=0.38p ps=2.38u w=2u l=0.5u
X115 a_n11430_n13770# IBIAS GND GND sg13_lv_nmos ad=0.19p pd=1.38u as=0.19p ps=1.38u w=1u l=0.15u
X116 OUTp VCTRL OUTp VDD sg13_lv_pmos ad=0.76p pd=4.38u as=0 ps=0 w=4u l=4u
X117 OUTp VCTRL OUTp VDD sg13_lv_pmos ad=0.76p pd=4.38u as=0 ps=0 w=4u l=4u
X118 GND IBIAS a_n11430_n13770# GND sg13_lv_nmos ad=0.19p pd=1.38u as=0.19p ps=1.38u w=1u l=0.15u
X119 a_n11430_n13770# IBIAS GND GND sg13_lv_nmos ad=0.19p pd=1.38u as=0.19p ps=1.38u w=1u l=0.15u
X120 VDD OUTp OUTn VDD sg13_lv_pmos ad=1.615p pd=8.88u as=1.615p ps=8.88u w=8.5u l=0.5u
X121 a_n11430_n13770# IBIAS GND GND sg13_lv_nmos ad=0.19p pd=1.38u as=0.19p ps=1.38u w=1u l=0.15u
X122 VDD OUTp OUTn VDD sg13_lv_pmos ad=1.615p pd=8.88u as=1.615p ps=8.88u w=8.5u l=0.5u
X123 GND IBIAS a_n11430_n13770# GND sg13_lv_nmos ad=0.19p pd=1.38u as=0.19p ps=1.38u w=1u l=0.15u
X124 GND IBIAS a_n11430_n13770# GND sg13_lv_nmos ad=0.19p pd=1.38u as=0.19p ps=1.38u w=1u l=0.15u
X125 a_n11430_n13770# OUTn OUTp GND sg13_lv_nmos ad=0.38p pd=2.38u as=0.38p ps=2.38u w=2u l=0.5u
X126 OUTn VCTRL OUTn VDD sg13_lv_pmos ad=0.76p pd=4.38u as=0 ps=0 w=4u l=4u
X127 a_n11430_n13770# OUTn OUTp GND sg13_lv_nmos ad=0.38p pd=2.38u as=0.38p ps=2.38u w=2u l=0.5u
X128 VDD OUTp OUTn VDD sg13_lv_pmos ad=2.89p pd=17.68u as=1.615p ps=8.88u w=8.5u l=0.5u
X129 GND IBIAS IBIAS GND sg13_lv_nmos ad=0.34p pd=2.68u as=0.34p ps=2.68u w=1u l=0.15u
X130 a_n11430_n13770# OUTn OUTp GND sg13_lv_nmos ad=0.38p pd=2.38u as=0.38p ps=2.38u w=2u l=0.5u
X131 VDD OUTp OUTn VDD sg13_lv_pmos ad=1.615p pd=8.88u as=2.89p ps=17.68u w=8.5u l=0.5u
X132 OUTn VCTRL OUTn VDD sg13_lv_pmos ad=0.76p pd=4.38u as=0 ps=0 w=4u l=4u
X133 OUTp OUTn cap_cmim l=4.26u w=4.26u
X134 GND IBIAS a_n11430_n13770# GND sg13_lv_nmos ad=0.19p pd=1.38u as=0.19p ps=1.38u w=1u l=0.15u
X135 a_n11430_n13770# IBIAS GND GND sg13_lv_nmos ad=0.19p pd=1.38u as=0.19p ps=1.38u w=1u l=0.15u
X136 OUTp VCTRL OUTp VDD sg13_lv_pmos ad=0.76p pd=4.38u as=0 ps=0 w=4u l=4u
X137 a_n11430_n13770# IBIAS GND GND sg13_lv_nmos ad=0.19p pd=1.38u as=0.19p ps=1.38u w=1u l=0.15u
X138 GND IBIAS a_n11430_n13770# GND sg13_lv_nmos ad=0.34p pd=2.68u as=0.19p ps=1.38u w=1u l=0.15u
X139 OUTp VCTRL OUTp VDD sg13_lv_pmos ad=0.76p pd=4.38u as=0 ps=0 w=4u l=4u
X140 GND IBIAS a_n11430_n13770# GND sg13_lv_nmos ad=0.19p pd=1.38u as=0.19p ps=1.38u w=1u l=0.15u
X141 a_n11430_n13770# IBIAS GND GND sg13_lv_nmos ad=0.19p pd=1.38u as=0.19p ps=1.38u w=1u l=0.15u
X142 OUTn VCTRL OUTn VDD sg13_lv_pmos ad=0.76p pd=4.38u as=0 ps=0 w=4u l=4u
X143 OUTp VCTRL OUTp VDD sg13_lv_pmos ad=0.76p pd=4.38u as=0 ps=0 w=4u l=4u
X144 a_n11430_n13770# IBIAS GND GND sg13_lv_nmos ad=0.19p pd=1.38u as=0.19p ps=1.38u w=1u l=0.15u
X145 a_n11430_n13770# IBIAS GND GND sg13_lv_nmos ad=0.19p pd=1.38u as=0.19p ps=1.38u w=1u l=0.15u
X146 OUTp VCTRL OUTp VDD sg13_lv_pmos ad=1.36p pd=8.68u as=0 ps=0 w=4u l=4u
X147 GND IBIAS a_n11430_n13770# GND sg13_lv_nmos ad=0.19p pd=1.38u as=0.19p ps=1.38u w=1u l=0.15u
X148 OUTn VCTRL OUTn VDD sg13_lv_pmos ad=0.76p pd=4.38u as=0 ps=0 w=4u l=4u
X149 a_n11430_n13770# OUTp OUTn GND sg13_lv_nmos ad=0.38p pd=2.38u as=0.38p ps=2.38u w=2u l=0.5u
X150 a_n11430_n13770# IBIAS GND GND sg13_lv_nmos ad=0.19p pd=1.38u as=0.19p ps=1.38u w=1u l=0.15u
X151 a_n11430_n13770# OUTp OUTn GND sg13_lv_nmos ad=0.38p pd=2.38u as=0.38p ps=2.38u w=2u l=0.5u
X152 VDD OUTp OUTn VDD sg13_lv_pmos ad=1.615p pd=8.88u as=1.615p ps=8.88u w=8.5u l=0.5u
X153 GND IBIAS a_n11430_n13770# GND sg13_lv_nmos ad=0.19p pd=1.38u as=0.19p ps=1.38u w=1u l=0.15u
X154 OUTp OUTn VDD VDD sg13_lv_pmos ad=1.615p pd=8.88u as=2.89p ps=17.68u w=8.5u l=0.5u
X155 OUTp OUTn VDD VDD sg13_lv_pmos ad=1.615p pd=8.88u as=1.615p ps=8.88u w=8.5u l=0.5u
X156 a_n11430_n13770# IBIAS GND GND sg13_lv_nmos ad=0.19p pd=1.38u as=0.19p ps=1.38u w=1u l=0.15u
X157 OUTp VCTRL OUTp VDD sg13_lv_pmos ad=0.76p pd=4.38u as=0 ps=0 w=4u l=4u
X158 a_n11430_n13770# OUTn OUTp GND sg13_lv_nmos ad=0.38p pd=2.38u as=0.38p ps=2.38u w=2u l=0.5u
X159 a_n11430_n13770# IBIAS GND GND sg13_lv_nmos ad=0.19p pd=1.38u as=0.19p ps=1.38u w=1u l=0.15u
X160 OUTp VCTRL OUTp VDD sg13_lv_pmos ad=0.76p pd=4.38u as=0 ps=0 w=4u l=4u
X161 OUTn VCTRL OUTn VDD sg13_lv_pmos ad=0.76p pd=4.38u as=0 ps=0 w=4u l=4u
X162 a_n11430_n13770# OUTp OUTn GND sg13_lv_nmos ad=0.68p pd=4.68u as=0.38p ps=2.38u w=2u l=0.5u
X163 GND IBIAS a_n11430_n13770# GND sg13_lv_nmos ad=0.19p pd=1.38u as=0.19p ps=1.38u w=1u l=0.15u
X164 OUTp OUTn cap_cmim l=4.26u w=4.26u
X165 OUTn VCTRL OUTn VDD sg13_lv_pmos ad=0.76p pd=4.38u as=0 ps=0 w=4u l=4u
X166 OUTp OUTn VDD VDD sg13_lv_pmos ad=1.615p pd=8.88u as=1.615p ps=8.88u w=8.5u l=0.5u
X167 OUTp OUTn VDD VDD sg13_lv_pmos ad=1.615p pd=8.88u as=1.615p ps=8.88u w=8.5u l=0.5u
C0 VDD OUTn 34.6872f
C1 OUTp OUTn 22.7425f
C2 VDD OUTp 35.5897f
C3 VCTRL OUTn 7.49415f
C4 a_n2842_n10474# OUTn 0.03661f
C5 a_n11430_n13770# IBIAS 0.88362f
C6 VDD VCTRL 0.11371p
C7 VCTRL OUTp 8.69969f
C8 a_n11430_n13770# OUTn 5.36181f
C9 a_n2842_n10474# OUTp 0.0345f
C10 a_n11430_n13770# OUTp 2.83726f
R0 IBIAS.n2 IBIAS.n1 15.3132
R1 IBIAS.n2 IBIAS.n0 5.60402
R2 IBIAS IBIAS.n2 0.480361
R3 GND.n25 GND.n9 3.24343e+06
R4 GND.n33 GND.n32 2.67515e+06
R5 GND.n34 GND.n33 1.5764e+06
R6 GND.n33 GND.n9 18951.4
R7 GND.n23 GND.n9 3454.44
R8 GND.n32 GND.n31 1395.09
R9 GND.n32 GND.n10 1383.98
R10 GND.n35 GND.n7 1159.56
R11 GND.n7 GND.n6 273.729
R12 GND.n27 GND.n24 238.835
R13 GND.n20 GND.n12 198.18
R14 GND.n19 GND.n18 155.909
R15 GND.n14 GND.n13 138.99
R16 GND.n17 GND.n3 115.368
R17 GND.n27 GND.n23 106.578
R18 GND.n37 GND.n8 104.294
R19 GND.n44 GND.n43 100.897
R20 GND.n42 GND.n41 99.4221
R21 GND.n40 GND.n39 98.9181
R22 GND.n38 GND.n5 98.726
R23 GND.n39 GND.n38 94.6815
R24 GND.n41 GND.n40 91.8402
R25 GND.n8 GND.n5 87.4156
R26 GND.n44 GND.n42 82.2331
R27 GND.n35 GND.n34 80.3213
R28 GND.n26 GND.n16 72.8013
R29 GND.n34 GND.n1 69.9295
R30 GND.n27 GND.n26 66.7346
R31 GND.n29 GND.n25 66.0776
R32 GND.n37 GND.n36 65.656
R33 GND.n18 GND.n17 56.4055
R34 GND.n28 GND.n27 54.6011
R35 GND.n43 GND.n3 51.2645
R36 GND.n36 GND.n35 41.4058
R37 GND.n16 GND.n15 22.8722
R38 GND.n10 GND.n2 17.0005
R39 GND.n45 GND.n44 17.0005
R40 GND.n45 GND.n41 17.0005
R41 GND.n45 GND.n39 17.0005
R42 GND.n45 GND.n5 17.0005
R43 GND.n19 GND.n1 17.0005
R44 GND.n28 GND.n1 17.0005
R45 GND.n31 GND.n30 17.0005
R46 GND.n21 GND.n11 17.0005
R47 GND.n30 GND.n16 17.0005
R48 GND.n30 GND.n14 17.0005
R49 GND.n30 GND.n12 17.0005
R50 GND.n21 GND.n20 17.0005
R51 GND.n26 GND.n1 17.0005
R52 GND.n10 GND.n4 16.0347
R53 GND.n29 GND.n28 14.7118
R54 GND.n15 GND.n14 14.1331
R55 GND.n13 GND.n12 11.5891
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
R159 OUTp.n5 OUTp.n3 0.0120043
R160 OUTp.n8 OUTp.n7 0.0120043
R161 OUTp.n8 OUTp.n6 0.0120043
C11 OUTn GND 34.3726f
C12 IBIAS GND 13.8018f
C13 OUTp GND 34.5342f
C14 VCTRL GND 23.4512f
C15 VDD GND 17.8494f
C16 a_n2842_n10474# GND 0.13944f
C17 a_n11430_n13770# GND 15.0236f $ **FLOATING
.ends
