SkillSurf/frac-n-pll-vco-mixdes_2026/schematic/blocks/charge-pump/simulations/CP_lvs.pex.spice

* NGSPICE file created from CP_lvs.ext - technology: ihp-sg13g2

.subckt CP_lvs CTRL2 CTRL VDD CTRL1 GND Vbn Ibias UP DN
X0 a_n15995_15200# a_4075_15440# rsil l=100u w=0.5u
X1 a_n12027_n1680# VDD GND GND sg13_lv_nmos ad=1.02p pd=6.68u as=1.02p ps=6.68u w=3u l=2u
X2 Vbn Vbn a_n12027_n1680# GND sg13_lv_nmos ad=1.02p pd=6.68u as=1.02p ps=6.68u w=3u l=2u
X3 a_n15985_11101# a_4085_11341# rsil l=100u w=0.5u
X4 a_n15995_15680# a_4075_15920# rsil l=100u w=0.5u
X5 CTRL GND cap_cmim l=60u w=60u
X6 a_n15995_12800# CTRL1 rsil l=100u w=0.5u
X7 a_n15985_11581# a_4085_11821# rsil l=100u w=0.5u
X8 CTRL1 GND cap_cmim l=15u w=20u
X9 a_n15995_15680# a_4075_15440# rsil l=100u w=0.5u
X10 a_n15995_16160# a_4075_16400# rsil l=100u w=0.5u
X11 a_n15985_11581# a_4085_11341# rsil l=100u w=0.5u
X12 Vbn Ibias a_n12027_1365# VDD sg13_lv_pmos ad=3.4p pd=20.68u as=3.4p ps=20.68u w=10u l=2u
X13 CTRL2 GND cap_cmim l=40u w=40u
X14 a_n15985_12061# CTRL1 rsil l=100u w=0.5u
X15 a_n15031_1369# GND VDD VDD sg13_lv_pmos ad=3.4p pd=20.68u as=3.4p ps=20.68u w=10u l=2u
X16 Ibias Ibias a_n15031_1369# VDD sg13_lv_pmos ad=3.4p pd=20.68u as=3.4p ps=20.68u w=10u l=2u
X17 CTRL1 Ibias a_n9531_1359# VDD sg13_lv_pmos ad=3.4p pd=20.68u as=3.4p ps=20.68u w=10u l=2u
X18 a_n15995_16160# a_4075_15920# rsil l=100u w=0.5u
X19 a_n15995_12800# a_4075_13040# rsil l=100u w=0.5u
X20 a_n15985_12061# a_4085_11821# rsil l=100u w=0.5u
X21 CTRL1 GND cap_cmim l=15u w=20u
X22 a_n15995_16640# a_4075_16400# rsil l=100u w=0.5u
X23 a_n15995_13280# a_4075_13520# rsil l=100u w=0.5u
X24 a_n15995_17120# a_4075_16880# rsil l=100u w=0.5u
X25 a_n15995_13280# a_4075_13040# rsil l=100u w=0.5u
X26 a_n15995_16640# a_4075_16880# rsil l=100u w=0.5u
X27 a_n15995_13760# a_4075_14000# rsil l=100u w=0.5u
X28 a_n15995_17600# a_4075_17360# rsil l=100u w=0.5u
X29 a_n15995_13760# a_4075_13520# rsil l=100u w=0.5u
X30 CTRL1 Vbn a_n9528_n1680# GND sg13_lv_nmos ad=1.02p pd=6.68u as=1.02p ps=6.68u w=3u l=2u
X31 a_n15995_17120# a_4075_17360# rsil l=100u w=0.5u
X32 CTRL1 GND cap_cmim l=15u w=20u
X33 a_n15995_14240# a_4075_14000# rsil l=100u w=0.5u
X34 a_n15995_17600# a_4075_17840# rsil l=100u w=0.5u
X35 a_n15985_10141# CTRL rsil l=100u w=0.5u
X36 a_n15995_14720# a_4075_14480# rsil l=100u w=0.5u
X37 CTRL2 GND cap_cmim l=40u w=40u
X38 a_n15985_10621# a_4085_10381# rsil l=100u w=0.5u
X39 CTRL2 GND cap_cmim l=40u w=40u
X40 a_n15995_18080# a_4075_18320# rsil l=100u w=0.5u
X41 a_n15995_14240# a_4075_14480# rsil l=100u w=0.5u
X42 CTRL1 GND cap_cmim l=15u w=20u
X43 a_n15995_15200# a_4075_14960# rsil l=100u w=0.5u
X44 a_n15985_10141# a_4085_10381# rsil l=100u w=0.5u
X45 a_n15995_14720# a_4075_14960# rsil l=100u w=0.5u
X46 a_n15985_11101# a_4085_10861# rsil l=100u w=0.5u
X47 a_n9531_1359# UP VDD VDD sg13_lv_pmos ad=3.4p pd=20.68u as=3.4p ps=20.68u w=10u l=2u
X48 a_n15995_18080# a_4075_17840# rsil l=100u w=0.5u
X49 a_n15985_10621# a_4085_10861# rsil l=100u w=0.5u
X50 a_n12027_1365# GND VDD VDD sg13_lv_pmos ad=3.4p pd=20.68u as=3.4p ps=20.68u w=10u l=2u
X51 a_n9528_n1680# DN GND GND sg13_lv_nmos ad=1.02p pd=6.68u as=1.02p ps=6.68u w=3u l=2u
X52 CTRL2 GND cap_cmim l=40u w=40u
X53 CTRL2 a_4075_18320# rsil l=100u w=0.5u
C0 CTRL1 a_4085_11821# 0.04484f
C1 a_n15985_10141# a_n15985_10621# 0.05154f
C2 a_n15925_15920# a_n15925_15680# 1.72382f
C3 a_n15995_12800# CTRL1 0.30878f
C4 a_n15925_14480# a_n15925_14240# 1.72382f
C5 a_n15925_14000# a_4075_14000# 0.02486f
C6 a_n15925_14480# a_n15925_14720# 1.72382f
C7 CTRL CTRL1 0.17732f
C8 a_n15915_11821# a_n15985_11581# 0.02221f
C9 a_n15985_10621# a_n15915_10861# 0.02282f
C10 a_4075_15440# a_4075_15920# 0.07828f
C11 a_n15925_18080# a_n15995_18080# 0.02372f
C12 a_n15985_12061# CTRL1 0.23412f
C13 a_n15925_18080# a_n15925_17840# 1.72382f
C14 a_n15925_14000# a_n15995_13760# 0.02258f
C15 a_4085_10861# a_n15915_10861# 0.02401f
C16 a_n15925_18080# CTRL2 0.01662f
C17 VDD UP 3.42112f
C18 a_4075_17840# a_n15925_18080# 0.02295f
C19 a_n15995_13760# a_n15925_13760# 0.02258f
C20 m2_n11062_3177# UP 0.12521f
C21 a_n15925_13760# a_n15925_13520# 1.72382f
C22 a_n15915_10621# a_n15915_10861# 1.72382f
C23 a_n15925_18080# a_n15925_18320# 1.72382f
C24 DN Ibias 0.10776f
C25 a_n15915_12061# a_4085_11821# 0.0251f
C26 a_n15925_15200# a_n15995_15200# 0.0227f
C27 a_n12027_n1680# VDD 0.07895f
C28 a_n15925_17120# a_n15925_17360# 1.72382f
C29 a_4075_17360# a_n15925_17360# 0.02457f
C30 a_n15915_12301# a_n15985_12061# 0.02319f
C31 CTRL1 a_n15995_13280# 0.26946f
C32 a_4085_10381# a_n15915_10381# 0.0243f
C33 a_n9528_n1680# Vbn 0.08131f
C34 a_n15915_11101# CTRL1 0.03004f
C35 DN Vbn 0.24272f
C36 a_n9531_1359# VDD 0.45036f
C37 a_n15995_18080# CTRL2 0.06662f
C38 a_n15985_10141# a_n15915_10141# 0.0227f
C39 a_n15925_15200# a_n15925_14960# 1.72382f
C40 a_4075_17840# a_n15925_17840# 0.02295f
C41 a_n15985_12061# a_n15915_12061# 0.02319f
C42 a_n15995_17120# a_n15995_17600# 0.04454f
C43 a_n15995_14720# CTRL1 0.26381f
C44 a_n15915_10621# a_n15915_10381# 1.72382f
C45 VDD Ibias 8.12047f
C46 a_n15925_18320# a_n15995_18080# 0.02372f
C47 CTRL2 CTRL1 2.72178f
C48 a_n15925_14720# a_n15995_14720# 0.02258f
C49 a_n15915_11581# a_n15985_11581# 0.02221f
C50 a_n15995_16640# CTRL2 0.02902f
C51 a_n15925_17600# a_n15995_17600# 0.024f
C52 a_n15925_14240# CTRL1 0.01237f
C53 a_4075_14480# a_4075_14000# 0.0641f
C54 m2_n11062_3177# Ibias 0.01138f
C55 a_n15925_18320# CTRL2 0.08539f
C56 a_n15925_13040# a_n15925_12800# 1.72382f
C57 a_n15915_11581# a_n15915_11341# 1.72382f
C58 a_n15915_11101# a_n15985_11101# 0.02184f
C59 VDD Vbn 0.55842f
C60 a_n15995_14240# a_n15995_13760# 0.0643f
C61 a_4085_11341# a_4085_10861# 0.05739f
C62 a_n15985_10141# a_n15915_10381# 0.0227f
C63 a_4075_13520# a_n15925_13760# 0.02233f
C64 a_n15925_16160# a_n15995_16160# 0.02245f
C65 a_4075_13040# a_n15925_13280# 0.02344f
C66 a_4085_11341# a_n15915_11341# 0.02626f
C67 a_4085_10381# CTRL 0.04614f
C68 CTRL Ibias 0.01958f
C69 a_n15995_12800# a_n15925_12800# 0.02319f
C70 a_n15985_11101# CTRL1 0.23445f
C71 a_n15925_14480# a_n15995_14240# 0.02332f
C72 a_n15915_10381# a_n15915_10141# 1.72382f
C73 a_4075_17840# a_4075_17360# 0.04579f
C74 a_n15985_12061# a_n15985_11581# 0.04592f
C75 a_n15925_14480# a_4075_14480# 0.02332f
C76 a_n15925_14000# CTRL1 0.02228f
C77 a_n15925_14000# a_n15925_14240# 1.72382f
C78 a_n15925_15200# a_n15925_15440# 1.72382f
C79 a_n15915_12301# CTRL1 1.65753f
C80 a_n9528_n1680# DN 0.07895f
C81 a_n15915_11581# a_n15915_11821# 1.72382f
C82 a_n15915_10621# CTRL 0.06256f
C83 CTRL2 UP 0.01364f
C84 m2_n14066_3181# Ibias 0.10361f
C85 a_4075_15920# a_n15925_15920# 0.02344f
C86 CTRL1 a_n15915_12061# 0.2262f
C87 a_n15925_15920# a_n15995_15680# 0.02319f
C88 a_n15925_13760# CTRL1 0.03302f
C89 a_4075_18320# a_n15925_18560# 0.02307f
C90 a_n15915_11821# a_4085_11821# 0.02512f
C91 a_n15925_13040# a_n15925_13280# 1.72382f
C92 a_n15925_13280# a_n15925_13520# 1.72382f
C93 a_n15915_11101# a_4085_10861# 0.02401f
C94 Ibias a_n12027_1365# 0.2108f
C95 VDD DN 1.96396f
C96 a_n15995_15200# a_n15925_15440# 0.0227f
C97 a_4075_14960# a_4075_14480# 0.0641f
C98 a_n15925_16880# a_n15995_16640# 0.02258f
C99 a_n15925_13040# a_4075_13040# 0.02344f
C100 a_n9531_1359# CTRL1 0.1388f
C101 a_n15925_15200# a_4075_14960# 0.02488f
C102 a_4075_16400# a_n15925_16400# 0.02516f
C103 a_n15915_10141# CTRL 0.16036f
C104 a_n15915_10861# CTRL 0.0208f
C105 a_n15915_11101# a_n15915_11341# 1.72382f
C106 Vbn a_n12027_1365# 0.13817f
C107 a_n15985_10621# CTRL1 0.21315f
C108 a_n15915_12301# a_n15915_12061# 1.72382f
C109 a_n15925_14000# a_n15925_13760# 1.72382f
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
C266 a_4075_14960# GND 0.26851f $ **FLOATING
C267 a_n15925_15200# GND 9.39456f
C268 a_n15925_15440# GND 9.39456f
C269 a_n15995_15200# GND 0.22352f $ **FLOATING
C270 a_4075_15440# GND 0.26835f $ **FLOATING
C271 a_n15925_15680# GND 9.39456f
C272 a_n15925_15920# GND 9.39456f
C273 a_n15995_15680# GND 0.27028f $ **FLOATING
C274 a_4075_15920# GND 0.27057f $ **FLOATING
C275 a_n15925_16160# GND 9.39456f
C276 a_n15925_16400# GND 9.39456f
C277 a_n15995_16160# GND 0.26621f $ **FLOATING
C278 a_4075_16400# GND 0.26841f $ **FLOATING
C279 a_n15925_16640# GND 9.39456f
C280 a_n15925_16880# GND 9.39456f
C281 a_n15995_16640# GND 0.24607f $ **FLOATING
C282 a_4075_16880# GND 0.26889f $ **FLOATING
C283 a_n15925_17120# GND 9.39456f
C284 a_n15925_17360# GND 9.39456f
C285 a_n15995_17120# GND 0.23606f $ **FLOATING
C286 a_4075_17360# GND 0.26242f $ **FLOATING
C287 a_n15925_17600# GND 9.39456f
C288 a_n15925_17840# GND 9.39456f
C289 a_n15995_17600# GND 0.2412f $ **FLOATING
C290 a_4075_17840# GND 0.26247f $ **FLOATING
C291 a_n15925_18080# GND 9.39456f
C292 a_n15925_18320# GND 9.39456f
C293 a_n15995_18080# GND 0.23303f $ **FLOATING
C294 a_4075_18320# GND 0.29189f $ **FLOATING
C295 a_n15925_18560# GND 11.3368f
.ends
