SkillSurf/frac-n-pll-vco-mixdes_2026/schematic/blocks/top-pll/simulations/LC_VCO_tb.spice

** sch_path: /foss/designs/iic_osic_tools/frac-n-pll-vco-unic_cass/schematic/blocks/top-pll/lc-vco/LC_VCO_tb.sch
**.subckt LC_VCO_tb OUTp OUTn VDD VCTRL GND Ibias
*.opin OUTp
*.opin OUTn
*.iopin VDD
*.iopin VCTRL
*.iopin GND
*.iopin Ibias
V1 VDD GND 1.2
V2 VCTRL GND 0.6
I0 VDD Ibias 50u
x1 VDD OUTp OUTn Ibias VCTRL GND LC_VCO
**** begin user architecture code
 .lib cornerMOSlv.lib mos_tt
.lib cornerRES.lib res_typ
.lib /foss/pdks/ihp-sg13g2/libs.tech/ngspice/models/cornerCAP.lib cap_typ_stat



.include ./IHP_4nH_Inductor.spice
.param temp=27
.control
.ic v(OUTp)=0.6

.options maxstep=10n reltol=1e-3 abstol=1e-6
save v(OUTp) V(CTRL)
tran 1p 0.2u UIC

* Save transient waveform to raw file
write LC_VCO_tb.raw

* Plot time-domain waveform
plot v(OUTp) xlimit 5n 60n

* Perform FFT on output
fft v(OUTp)

* Convert FFT magnitude to dB
let vmag = db(mag(v(OUTp)))

* ---- DETECT LARGEST FFT PEAK (ROBUST METHOD) ----
let peak_mag = vecmax(vmag)

* Find index using where()
let peak_index = 0
let peak_index = index(vmag, peak_mag)

let peak_freq = frequency[peak_index]

echo 'Largest_FFT_Peak_Frequency_Hz:' peak_freq
echo 'Largest_FFT_Peak_Magnitude_dB:' peak_mag
* Plot FFT result
plot vmag xlabel 'Frequency (Hz)' xlimit 0 5G

* Save FFT data to text file
wrdata fft_output(VCTRL=0.7).txt vmag

.endc


**** end user architecture code
**.ends

* expanding   symbol:  lc-vco/LC_VCO.sym # of pins=6
** sym_path: /foss/designs/iic_osic_tools/frac-n-pll-vco-unic_cass/schematic/blocks/top-pll/lc-vco/LC_VCO.sym
** sch_path: /foss/designs/iic_osic_tools/frac-n-pll-vco-unic_cass/schematic/blocks/top-pll/lc-vco/LC_VCO.sch
.subckt LC_VCO VDD OUTp OUTn Ibias VCTRL GND
*.iopin VDD
*.opin OUTp
*.opin OUTn
*.iopin GND
*.iopin VCTRL
*.iopin Ibias
XM6 net1 Ibias GND GND sg13_lv_nmos w=1u l=0.15u ng=1 m=60
XM5 Ibias Ibias GND GND sg13_lv_nmos w=1u l=0.15u ng=1 m=1
XM4 OUTp OUTn VDD VDD sg13_lv_pmos w=8.5u l=0.5u ng=1 m=13
X5M3 OUTn OUTp VDD VDD sg13_lv_pmos w=8.5u l=0.5u ng=1 m=13
XM2 OUTp OUTn net1 GND sg13_lv_nmos w=2u l=0.5u ng=1 m=12
XM1 OUTn OUTp net1 GND sg13_lv_nmos w=2u l=0.5u ng=1 m=12
XC3 OUTp OUTn cap_cmim w=4.0e-6 l=4.0e-6 m=13.6
XMv2 OUTp VCTRL OUTp VDD sg13_lv_pmos w=4u l=4u ng=1 m=22
XMv1 OUTn VCTRL OUTn VDD sg13_lv_pmos w=4u l=4u ng=1 m=22
XR1 OUTn OUTp sub! rhigh w=1e-6 l=1e-6 m=1.23 b=0
x1 OUTn OUTp ihp_4nh_inductor
.ends

.GLOBAL GND
.GLOBAL VDD
.GLOBAL VCTRL
.GLOBAL Ibias
.end
