SkillSurf/frac-n-pll-vco-mixdes_2026/schematic/blocks/top-pll/simulations/dc_lv_nmos.spice

** sch_path: /home/mmhnbm/.ciel/ciel/ihp-sg13g2/versions/c4b8b4e5e7a05f375cca3815d51b3a37721fbf5c/ihp-sg13g2/libs.tech/xschem/sg13g2_tests/dc_lv_nmos.sch
**.subckt dc_lv_nmos
Vgs G GND 1.2
Vds D GND 1.5
Vd D net1 0
.save i(vd)
XM1 net1 G GND GND sg13_lv_nmos w=1.0u l=0.45u ng=1
**** begin user architecture code

.lib /home/mmhnbm/.ciel/ciel/ihp-sg13g2/versions/c4b8b4e5e7a05f375cca3815d51b3a37721fbf5c/ihp-sg13g2/libs.tech/ngspice/models/cornerMOSlv.lib mos_tt



.include dc_lv_nmos.save
.param temp=27
.control
save all
op
write dc_lv_nmos.raw
set appendwrite
dc Vds 0 1.2 0.01 Vgs 0.3 1.0 0.1
write dc_lv_nmos.raw
.endc


**** end user architecture code
**.ends
.GLOBAL GND
.end
