SkillSurf/frac-n-pll-vco-mixdes_2026/(commit log)

2025-09-28 Freq. divider QUCS simulations added
    [240_248_Divider.sch, 30_31_DMD.sch, 4_5_Prescaler.sch, Mod_7_DFF.sch, Mod_7_JK.sch]
2025-10-03 VCO schemetics created
    [LC_VCO.sch]
2025-10-03 VCO_test bench created
    [LC_VCO_tb.sch]
2025-10-03 VCO simulated for 0.1v to 1.8 v, VCO range verified
2025-10-04 VCO cap optimized
    [LC_VCO.sch]
2026-01-03 design files of dsm block added.
    [dsm_top_tb.sch]
2026-02-12 vco updated
    [LC_VCO.sch, LC_VCO_tb.sch]
2026-02-16 Inductor subckt verification in Qucs
    [4n_ind_spar.sch]
2026-02-16 Inductor
    Updated all the documents in repo.
    Organized all the content and the folder includes the results as well.
    [Radius_180um_220um.csv, Seperation_variations.csv, Width_variations.csv]
2026-02-17 Clean VCO ngspice update (without raw files)
    [LC_VCO_tb.sch]
2026-02-17 Inductor_xschem_simulation updated
    [tb-ind.sch, tb-tran.sch]
2026-02-17 LC_VCO updated with the inductor
    [LC_VCO.sch, LC_VCO_tb.sch]
2026-02-21 converted dsm to active high reset device.
    [dsm_9bit.v, dsm_top.v, dsm_top_tb.v, generate_stimuli.py, generate_sym.py]
2026-02-22 pll combining
    [CP.sch, Freq_Div_std.sch, LC_VCO.sch, LC_VCO_sweep_tb.sch, LC_VCO_tb.sch, PFD_CP_LCVCO_Frequency_Divider_tb.sch, PFD_CP_LCVCO_tb.sch, PFD_CP_tb.sch]
2026-02-23 Final inductor files
    simulated the final inductor and updated the repo with the new CSV files and the relavant plots.
    [All_params_5_increased.csv, All_params_5_reduced.csv, Final_inductor.csv]
2026-02-23 dsm and mdiv
    [dsm_with_mdiv_tb.sch]
2026-02-24 vco r updated
    [CP.sch, Freq_Div_std.sch, Frequency_Divider_tb.sch, LC_VCO.sch, LC_VCO_sweep_tb.sch, LC_VCO_tb.sch, PFD_CP_LCVCO_tb.sch, PFD_CP_tb.sch]
2026-02-27 DSM added clean
    [LCVCO_DSM_tb.sch, PFD_CP_LCVCO_tb.sch, pll_dsm_freqdivider.sch]
2026-02-28 pll circuit updated
    [LCVCO_DSM_tb.sch, PFD_CP_tb.sch, dsm_with_mdiv_tb.sch, pll_dsm_freqdivider.sch, pll_temp_fredivider.sch]
2026-02-28 pll sym created
    [LCVCO_DSM_tb.sch, PFD_CP_LCVCO_tb.sch, pll.sch, pll_tb.sch, pll_temp_fredivider.sch]
2026-03-01 file names updated
    [LCVCO_temp_Fredivider_tb.sch, pll_temp_fredivider_tb.sch]
2026-03-02 LCVCO dsm simulation working.
    [LCVCO_DSM_tb.sch, LCVCO_temp_Fredivider_tb.sch, LC_VCO.sch]
2026-03-02 LC VCO testbench is working
    [LC_VCO.sch, LC_VCO_tb.sch, pll_temp_fredivider_tb.sch]
2026-03-02 CP testbench is working and some duplicate files are cleared
    [CP.sch, LC_VCO.sch, LC_VCO_tb.sch, PFD_CP_tb.sch]
2026-03-03 VCO PN try
    [LCVCO_temp_Fredivider_tb.sch, LC_VCO_PN_tb.sch, pll_dsm_freqdivider_tb.sch]
2026-03-04 pll symbol updated
    [LCVCO_temp_Fredivider_tb.sch, LC_VCO.sch, pll.sch, pll_dsm_freqdivider_tb.sch, pll_temp_fredivider_tb.sch]
2026-03-04 pll _dsm simulated
    [pll.sch, pll_dsm_freqdivider_tb.sch, pll_temp_fredivider_tb.sch, top_pll_tb.sch]
2026-03-04 :wqpll symbol simulated
    [top_pll_op.sch, top_pll_tb.sch]
2026-03-05 Combined simulation shows less oscilations in Vctrl (41mV peak to peak)
    [CP.sch, top_pll_tb.sch]
2026-03-07 VCO tb updated
    [LC_VCO_tb.sch]
2026-03-11 VCO GDS created
    [PFD_std.sch]
2026-03-13 pfd lvs passed
    [CP.sch, PFD_std.sch]
2026-03-14 CP and topplltb updated
    [CP.sch, top_pll_tb.sch]
2026-03-14 PFD pex done
    [PFD_std.sch, PFD_std_pex_tb.sch]
2026-03-14 CP+LP Layout,DRC,LVS, PEX passed
    [CP_lvs.sch, PFD_CP_pex_tb.sch, PFD_std_pex_tb.sch, Top_CP.sch]
2026-03-15 LC VCO Minimal, maximal DRC done, LVS done, PEX done
    [LC_VCO.sch, LC_VCO_pex_tb.sch, LC_VCO_tb.sch]
2026-03-19 GDS are finalised
    [CP.sch, LC_VCO.sch, dsm_with_mdiv_pex_tb.sch, top_pll.sch]
2026-03-19 Python files for plots are added
    [LC_VCO_response_tb.sch]
2026-03-21 refactor: improve naming for clarity and consistency
    [LC_VCO_PLL.sch]
2026-03-21 Induvidual block naming fixed , minimal maximal drc, lvs passed
    [LC_VCO_PLL.sch]
2026-03-22 updated files
    [CP_lvs.sch, LC_VCO_sweep_tb.sch]
